majharuli0/smart-speaker-esp32/README.md

# ESP32 Smart Speaker: firmware

Firmware and product docs for an ESP32-S3 smart speaker: alarms with your own tones (they ring even
without internet), a doorbell, hold-to-talk, volume, device health, updates over Wi-Fi, and Wi-Fi setup
over Bluetooth. See [docs/ROADMAP.md](docs/ROADMAP.md) and [docs/APP_PLAN.md](docs/APP_PLAN.md).

The rest of the system lives in its own repos:

| Repo | What |
|---|---|
| **smart-speaker-esp32** (this one) | Firmware, hardware notes, product docs, the device protocol |
| [smart-speaker-backend](https://github.com/majharuli0/smart-speaker-backend) | NestJS API + Postgres, accounts, and the MQTT broker (EMQX) the speakers connect to |
| [smart-speaker-web](https://github.com/majharuli0/smart-speaker-web) | React web app |
| [smart-speaker-app](https://github.com/majharuli0/smart-speaker-app) | Expo (React Native) phone app: adds a speaker by its QR label and Bluetooth |

```
├── firmware/    ESP32 program: firmware.ino (startup + commands), net, audio, alarms, tonecache, ota, health, stats, config.h
├── hardware/    Schematics and enclosure (later)
└── docs/        Roadmap, app plan, protocol; archive/ holds the earlier design doc
```

## 1. Secrets

Copy `firmware/secrets.example.h` to `firmware/secrets.h` (not in git) and set:
- `MQTT_URI`: the broker. At home: `mqtt://speaker-server.local:1883`. The computer running the
  backend's `docker compose` answers to that name (mDNS), so its address can change. In the cloud:
  `mqtts://<domain>:8883`. Each speaker logs in as itself, and the backend checks it.
- `DEVICE_SECRET`: the same value as `DEVICE_SECRET` in the backend's `.env`. It produces each speaker's
  QR label code and its MQTT password.

## 2. Flash the ESP32

All board settings and library versions come from [firmware/sketch.yaml](firmware/sketch.yaml). Needs
[arduino-cli](https://arduino.github.io/arduino-cli/) (`winget install ArduinoSA.CLI`).

```bash
cd firmware
./fw.sh build                 # compile for the ESP32-S3 → build/s3/firmware.ino.bin
./fw.sh upload COM11          # compile + upload (use your port)
./fw.sh monitor COM11         # serial monitor at 115200, Ctrl+C to quit
```

**Over Wi-Fi:** upload `firmware/build/s3/firmware.ino.bin` on the web app's **Firmware** page (admins),
then press **Update** under the speaker's Health. If the new version can't reach the server within
3 minutes, the device goes back to the previous one by itself.

At boot the serial monitor prints the speaker's UID and its label text: `QR label: SS:<UID>:<code>`.

## Making a unit (one command)

With a new ESP32-S3 on USB (Git Bash):

```bash
tools/make-unit.sh COM11          # wipe the chip, flash the firmware, make the label
tools/make-unit.sh COM11 --keep   # same without wiping (keeps Wi-Fi, settings and files)
```

It reads the speaker ID from the chip, builds and flashes the firmware (cloud address and secret from
`firmware/secrets.h`, which must match the backend's `DEVICE_SECRET`), writes the label
(`tools/labels/<UID>.html`: QR + ID, 70 × 40 mm, opened for printing) and adds a line to
`tools/units.csv`. On first start the speaker waits for Bluetooth setup and fetches the built-in tones
from the server.

## 3. Wi-Fi setup (over Bluetooth)

A speaker with no Wi-Fi saved advertises over Bluetooth as **`SS-XXXX`** (last 4 characters of its UID),
with a blue blinking light.

- **Phone app:** *Add a speaker* → scan the label (or type the speaker ID, the last 4 characters are
  enough) → pick your Wi-Fi → password. It's added to your account. A typed ID only works with the phone
  next to the speaker: the speaker itself confirms who set it up.
- **For testing, Espressif's "ESP BLE Provisioning" app:** scan the QR code the serial monitor shows (in
  the app's settings, clear the device name prefix "PROV_").

Bluetooth is switched off once Wi-Fi is set up. **Reset Wi-Fi**, or removing the speaker from your
account, brings it back to Bluetooth setup. Alarms keep working while it waits.

## Hardware

Board: **ESP32-S3-WROOM-1 N16R8** (16 MB flash, 8 MB PSRAM). The firmware only builds for this board.

The full wiring diagram, on the board's real pin order, is [docs/wiring.html](docs/wiring.html) (open it in a browser). The tables below say the same per part. A report-style circuit diagram with photos of each part is [docs/circuit-diagram.png](docs/circuit-diagram.png) (page: [docs/circuit-diagram.html](docs/circuit-diagram.html)).

Amp wiring (MAX98357A; GAIN to GND for 12 dB of gain, SD unconnected):

| Amp pin | ESP32-S3 |
|---|---|
| DIN | GPIO 4 |
| BCLK | GPIO 5 |
| LRC | GPIO 6 |
| VIN | 5V |
| GND | GND |
| GAIN | GND (12 dB) |

Status light (RGB LED, common cathode: the long leg to GND; each color through its own 330 Ω resistor (300 Ω works too)):

| LED leg | ESP32-S3 |
|---|---|
| Red | GPIO 15 |
| Green | GPIO 16 |
| Blue | GPIO 17 |
| Long leg | GND |

| Light | Meaning |
|---|---|
| White, brief | Starting |
| Blue, slow blink | Waiting for Wi-Fi setup over Bluetooth |
| Yellow, blinking | Connecting to Wi-Fi / the server |
| Green, dim (10 s, then off) | Online |
| Red, slow blink | Can't reach the server for 30 s (alarms still ring) |
| Orange, pulsing | Alarm ringing |
| Green, slow pulse | Music playing |
| Purple | Someone is talking through it |
| Cyan, blinking | Doorbell |
| Blue, fast blink | Firmware updating: don't unplug |
| Pink, pulsing | The microphone is on (always shown while it records) |
| White, flashing | "Find my speaker" (Blink button) |

The most important one shows when several apply (top of this order wins: updating, microphone, find, music, ringing, talking, doorbell, setup, offline, connecting, online).

microSD card module (SPI, powered from **3V3** unless the module has its own regulator; card formatted FAT32):

| SD module pin | ESP32-S3 |
|---|---|
| CS | GPIO 10 |
| MOSI | GPIO 11 |
| SCK | GPIO 12 |
| MISO | GPIO 13 |
| VCC | 3V3 |
| GND | GND |

INMP441 microphone (I2S, the second port; **3.3 V only**). Keep its wires short and away from the amp's:

| Mic pin | ESP32-S3 |
|---|---|
| VDD | **3V3** (not 5V) |
| GND | GND |
| SCK | GPIO 7 |
| WS | GPIO 8 |
| SD | GPIO 9 |
| L/R | GND (left channel) |

A second INMP441 can share the same SCK, WS and SD wires with its L/R pin to **3V3** (right
channel): the speaker uses the quieter of the two, and the mic test can record either or both.

Buttons (firmware 0.37.0+): two push buttons, each between its pin and **GND** (no resistor:
the internal pull-up is used).

| Button | ESP32-S3 | What it does |
|---|---|---|
| STOP · SOS (red) | GPIO 1 | Press: stops an alarm, reminder, music, Momo or a call. Hold 3 s: SOS, the family is alerted and their apps ring |
| MOMO | GPIO 2 | Press: Momo listens (like the wake word) |

DS3231 clock module (I2C, optional): keeps the time through power cuts, so alarms ring without
internet. With a plain CR2032 battery on the common ZS-042 board, remove its charging diode or resistor.

| Clock pin | ESP32-S3 |
|---|---|
| VCC | 3V3 |
| GND | GND |
| SDA | GPIO 21 |
| SCL | GPIO 47 |
| SQW, 32K | not connected |

The serial log shows `Clock from DS3231: …` at boot; the first time (new module), it shows
`not set yet` and then `DS3231 set from NTP` once the speaker is online.

Check the mic from the web app: the speaker's page → **Microphone** → **Record a test** (owner only).

Arduino IDE settings, if not using `./fw.sh`: Board **ESP32S3 Dev Module**, Flash Size **16MB**, PSRAM
**OPI PSRAM**, Partition Scheme **16M Flash (3MB APP/9.9MB FATFS)**, library **ArduinoJson** (v7),
upload through the USB-C port labelled **COM**.

## Protocol

The MQTT topics and every device message are in [docs/protocol.md](docs/protocol.md).

The old single-file server (`backend/`) and page (`web/`) were replaced by the repos above; they're in
this repo's git history.
