majharuli0/smart-speaker-esp32/hardware/README.md

# Hardware

Schematics, board layouts and enclosure files go here (roadmap Phase 5).

Current prototype wiring is in the main README.
