majharuli0/smart-speaker-esp32/docs/protocol.md

# Protocol

How the ESP32 and the server talk to each other (over MQTT, through our broker). This is the single reference for the device side: if code and this file disagree, fix one of them.

**Version:** matches firmware `0.13.0` and `smart-speaker-backend`; the audio sections (1b `mic`, 3.5 `turn_again` and `fd`, 3.6 `turn` and `mic_done`, 4, 4b, 6.1 `audio`) are updated to firmware `0.36.0` (2026-10-19). Audio work and its reasons: [AUDIO_PLAN.md](AUDIO_PLAN.md).

> The web page and phone app no longer talk to devices through a WebSocket: they use the backend's REST API and Socket.IO (see the `smart-speaker-backend` README and its Swagger docs at `/api/docs`). The device messages below are unchanged; where a section mentions the browser or `target`, the backend now sends that message on the user's behalf, after checking they own the device.

---

## 1. Connections

| What | Where | Used by |
|---|---|---|
| Web page | `GET http://<server>:3000/` (serves `web/`) | Browser |
| **WebSocket** (all messages below) | `ws://<server>:3000/` | Devices and browsers, one connection each |
| Tone upload | `POST /tones` | Browser |
| Tone download | `GET /tones/<name>.wav` | Device (while ringing), browser (preview) |
| Mic processor | `GET /mic-worklet.js` | Browser (hold to talk) |
| Firmware upload | `POST /firmware` | Browser |
| Firmware download | `GET /firmware/<board>.bin` | Device (while updating) |
| Visitor doorbell page | `GET /bell.html?d=<deviceId>` | Visitor's phone (link or QR code at the door) |
| Ring the doorbell | `POST /bell/<deviceId>` | Visitor page. See section 10. |
| Server discovery | mDNS: `led-server.local` → the server's LAN IP (A record) | Device, at boot |

- The device looks up `led-server.local` once at boot, and keeps retrying every second until it's found. It then keeps a WebSocket open to that IP, reconnecting every 3 s if it drops.
- All HTTP responses allow any origin (CORS `*`, header `X-Filename` allowed), so the page also works when opened as a file.

---

## 1b. Devices over MQTT (firmware 0.11.0+)

Devices connect to the **MQTT broker**, not to the server. Since firmware 0.13.0 that's **our own EMQX** (open source, in `smart-speaker-backend`'s docker-compose), which asks the backend about every login and topic. (0.11–0.12 used EMQX Cloud Serverless with one shared login; Serverless can't ask our backend.) The server connects to the same broker (`MQTT_URL` in `backend/.env`) and bridges devices to the web page, which still uses the WebSocket. **The JSON messages in section 3 are unchanged; only the route is different.**

| Topic | Direction | QoS | Carries |
|---|---|---|---|
| `ss/dev/<id>/cmd` | server → device | 1 | Everything in 3.4 and 3.5 (commands) |
| `ss/dev/<id>/audio` | server → device | 0 | Talk audio (section 4) |
| `ss/dev/<id>/evt` | device → server | 1 | Everything the device sends: `hello`, 3.6, `boot` |
| `ss/dev/<id>/online` | device | 1, retained | `1` on connect; the broker publishes `0` if the device drops (last will) |
| `ss/dev/<id>/mic` | device → server | 0 | Microphone audio (firmware 0.19.0+): 16 kHz 16-bit mono PCM in 120 ms pieces (3,840 bytes; 125 ms before 0.28), only while a `mic_record` runs. The mic is always on from 0.22.0 (for the wake word), but nothing is sent outside a `mic_record`. Since 0.28.0 this topic is only the fallback: mic audio goes over the audio link (section 4b) while it's up |
| `ss/server/online` | server | 1, retained | `1` when up (`0` is its last will). On `1`, a device sends `hello` and its reports again. **Known gap:** the server only counts a device as online after its `hello`. If a device's `hello` arrives while the server's MQTT login is still being refused (a quick restart of the dev server), it is missed, and the device won't say hello again because `ss/server/online` was already `1`. Fix by hand: publish `0`, then `1` (retained) to `ss/server/online`, or restart the backend once more. |
| `ss/server/http` | server | 1, retained | Base URL for downloads (tones, firmware), e.g. `http://192.168.0.102:3000`; `PUBLIC_URL` overrides it |

- **The device ID is taken from the topic**, never from the message, so a device can't pose as another.
- **Login, decided by the backend** (`/api/v1/broker/auth`):
  - each device logs in **as itself**: username = client ID = its device ID, password = HMAC-SHA256(`DEVICE_SECRET`, `"mqtt:" + id`) in hex. It's not the label code, so the printed label doesn't reveal it;
  - the backend logs in with `MQTT_USERNAME` / `MQTT_PASSWORD` (its `.env`) and may use every topic;
  - anything else is refused.
- **Topics, decided by the backend** (`/api/v1/broker/acl`): a device may only publish its own `evt`, `online` and `mic`, and only subscribe to its own `cmd` and `audio` plus `ss/server/online` and `ss/server/http`. So one device can't listen to, command, or pose as another.
- **Address:** `MQTT_URI` in `firmware/secrets.h` (not in git; template `secrets.example.h`). On your own network: `mqtt://speaker-server.local:1883`. The backend answers that name over mDNS with its computer's current address. The device looks it up before connecting, and again if the broker has been unreachable for 30 s (firmware 0.13.1+), so the computer's address may change. On the cloud server it becomes `mqtts://<domain>:8883`, checked against the ESP32's built-in bundle of trusted roots (no certificate file embedded).
- **Old firmware** (before 0.11.0) still connects by WebSocket, and the server accepts both.

---

## 2. Identities

- **Device ID:** `esp32-` + the chip's factory MAC address as 12 lowercase hex characters, e.g. `esp32-2884856409fc`. It never changes for a given chip.
- **UID:** what people see and type: the 12 hex characters in uppercase (`2884856409FC`). The `esp32-` ID is internal (MQTT topics, database, the label code); the API accepts the UID in URLs and when adding a device.
- **QR label:** `SS:<UID>:<code>`, e.g. `SS:2884856409FC:7f3a91c2`, with the UID printed next to it. The code is the first 8 hex characters of HMAC-SHA256(`DEVICE_SECRET`, internal device ID). The secret is in the firmware (`secrets.h`) and the backend (`.env`), so no per-device record is needed. The code is the **proof of ownership** when adding the device from its QR (`POST /api/v1/devices/claim`), which works even while it's online.
- **Adding by typing the ID** (firmware 0.17.0+): the user types the UID, or just its last 4 characters. The app finds `SS-XXXX` over Bluetooth, asks the backend for a **setup token** (`POST /api/v1/devices/claim-token`, valid 15 min, signed with `DEVICE_SECRET`) and writes it to the device's `ss-claim` setup endpoint. Once online, the device sends `{type:"claim", token}` after `hello`, and the backend adds it to that user's account, unless someone else owns it. Knowing a UID isn't enough: a phone has to be next to the speaker while it's in setup.
- **Bluetooth setup session:** Espressif provisioning, security 1 (encrypted). Since 0.17.0 its proof of possession is the Bluetooth name itself (`SS-XXXX`), so a typed ID is enough to connect; before, it was the label code.
- **Wi-Fi setup** (firmware 0.12.0+): with no Wi-Fi saved, the device advertises over Bluetooth as `SS-XXXX` (last 4 of the ID, uppercase) until a phone sends the details; then Bluetooth is switched off.
- **Wi-Fi recovery** (0.14.0+): if the saved network has been unreachable for 5 minutes (new router, changed password), the device also opens Bluetooth setup, while it keeps trying the old network. If the old network comes back first, Bluetooth closes again; if the app sends new details, the device switches to them.
- **Users** log in to the backend (`smart-speaker-backend`); each sees and controls only the devices they've added.

---

## 3. WebSocket messages

All text messages are JSON objects with a `type`. The only binary messages are talk audio (section 4).

### 3.1 Hello (first message on every connection)

| From | Message | Server's response |
|---|---|---|
| Device | `{type:"hello", role:"device", deviceId, fw, board}` | Registers the device, then sends `devices` to all browsers. The device follows up with `volume` and `partitions`. |
| Browser | `{type:"hello", role:"browser"}` | Sends that browser `devices`, `alarms`, `tones`, `firmware`, `events`, `server`, and each online device's latest status reports |

If a device reconnects before its old connection closes, the new connection replaces the old one. The device stays online.

### 3.2 Server → browsers

| Message | When |
|---|---|
| `{type:"devices", devices:[deviceId, ...]}` | On browser hello, and whenever a device comes online or goes offline |
| `{type:"alarms", alarms:[Alarm, ...], versions:{deviceId: version}}` | On browser hello, and after any alarm change. All alarms for all devices, plus the version each device should confirm (see 5). |
| `{type:"tones", tones:["name.wav", ...]}` | On browser hello, and after an upload |
| `{type:"talk_denied", deviceId, reason:"busy"\|"offline"}` | Only to the browser whose `talk_start` was refused |
| `{type:"firmware", firmware:{board: {board, version, size, sha256, uploaded}}}` | On browser hello, and after a firmware upload. The newest file per board. |
| `{type:"events", events:[Event, ...]}` | On browser hello: the newest 50 events (doorbell rings and device restarts) |
| `{type:"event", event:Event}` | A new event: a doorbell ring `{type:"doorbell", deviceId, source:"visitor"\|"page", at, delivered}` or a restart `{type:"boot", deviceId, reason, fw, crash?, at}` |
| `{type:"server", lanUrl}` | On browser hello: this server's network address (`http://192.168.x.x:3000`), for links other devices open. `null` if it has no network. |
| `{type:"doorbell_result", deviceId, ok:false, reason:"offline"}` | Only to a page whose `doorbell_ring` couldn't reach the device |

### 3.3 Browser → server (handled by the server, not relayed)

| Message | Effect |
|---|---|
| `{type:"alarm_save", alarm:Alarm}` | Create (no `id`) or replace (same `id`). Invalid alarms are ignored silently. See section 5. |
| `{type:"alarm_delete", id}` | Delete the alarm |
| `{type:"talk_start", target}` | Starts a talk session if nobody else is talking to `target` and it's online. Otherwise replies with `talk_denied`. On success it's also relayed to the device. |
| `{type:"talk_stop", target}` | Ends the session; also relayed to the device |
| `{type:"ota", target}` | Update `target` to the newest firmware for its board: sends it `ota_start`. If there's no file for its board, or it's offline, replies `{type:"ota", deviceId, state:"failed", error}`. |
| `{type:"doorbell_ring", target}` | Ring that device's doorbell (the page's 🔔 button). See section 10. |
| `{type:"set_timezone", target, tz}` | Saves an IANA zone name (e.g. `Asia/Dhaka`) for that device and sends it a `timezone`. Unknown names are ignored. |

### 3.4 Browser → device (relayed as-is to `target`)

The server forwards any other browser message to the device named in `target`. If the device is offline, the message is dropped.

| Message | Device does |
|---|---|
| `{type:"blink", target}` | "Find my speaker": the status light flashes white for 4 s |
| `{type:"ring", target, tone}` | Plays `tone` now (the **Test tone** button). Same behaviour as an alarm. |
| `{type:"stop", target}` | Stops ringing and talk |
| `{type:"snooze", target}` | If ringing: stop now and ring the same tone again in **9 minutes** (fading in). Timed by the device, so it works offline. Replies `snoozed`. |
| `{type:"talk_start", target}` / `{type:"talk_stop", target}` | See 3.3 and section 4 |
| `{type:"volume", target, value}` | Sets volume 0–100 and saves it on the device, then replies with `volume` |
| `{type:"volume", target}` | Only asks; the device replies with `volume` |
| `{type:"repeat", on}` | Music played from the file manager starts again at the end (`true`, the default) or plays once; saved on the device, which replies with `repeat`. Without `on`, it only asks. |
| `{type:"partitions", target}` | Asks for the flash layout; the device replies with `partitions` |
| `{type:"reset_wifi"}` | Forgets Wi-Fi and restarts into Bluetooth setup (`SS-XXXX`, firmware 0.12.0+) |

### 3.5 Server → device (from the server itself)

| Message | When |
|---|---|
| `{type:"timezone", tz, name}` | On connect, then every hour. `tz` is the POSIX rule the ESP32 uses, `name` the IANA zone. See section 8. |
| `{type:"alarms_sync", version, alarms:[{id, time, days, date?, tone, fade?, enabled}], tones:[{name, size, sha256}]}` | On connect, after any change to this device's alarms, and when a tone they use is re-uploaded. Only its own alarms, plus the tones they use (section 5). |
| `{type:"talk_stop"}` | The browser that was talking closed its tab or lost its connection |
| `{type:"watch", on}` | On hello, and whenever the first page opens (`true`) or the last one closes (`false`). Sets the stats rate. |
| `{type:"ota_start", path, version, size, sha256}` | After a browser's `ota`. See section 9. |
| `{type:"doorbell"}` | Someone rang: play the ding-dong |
| `{type:"sos_sent", people}` | The answer to the speaker's `sos` (0.37.0+): how many family members got the alert (a phone or an open app). The speaker stops resending it; 0: it plays its falling "no" notes (the server also says so in Bangla) |
| `{type:"momo_failed"}` | The MOMO button was pressed, but Momo can't start now (already listening, voice off, the day's limit): the speaker plays its falling notes |
| `{type:"mic_record", seconds, endSilence?, live?, wakeTake?, wakeTest?}` | Record (1–20 s): the device stops any sound, records, and streams it on `ss/dev/<id>/mic`; the light pulses pink meanwhile. With `endSilence` (ms) it plays its cue, starts 100 ms after it, and stops by itself once someone has spoken and then been quiet that long (a voice request): speech is 12 dB above the room's background, measured in 50 ms steps. The microphone test and voice requests both use it. Firmware 0.20.0+ (0.19.0 called it `mic_test`, without `endSilence`). From 0.22.0: **`live: true`** is a call (up to 600 s): the cue plays, talk keeps playing, and nothing is sent while the speaker plays sound or for 200 ms after (no echo of the caller); **`wakeTake: 1-3`** keeps the longest word said as that take of the wake word; **`wakeTest: true`** scores the word said against the takes (results in `mic_done`) |
| `{type:"mic_stop", quiet?}` | End a recording, call or conversation early (`stop` does too); `mic_done` still follows. A conversation ends with its falling tone unless `quiet` (0.26.0+) |
| `mic_record` with **`conversation: true, endSilence, idle`** | A conversation (0.26.0+): streams like a call (nothing sent while the speaker plays), and keeps the turns: `turn` events when the person starts and stops speaking (a turn ends after `endSilence` ms of quiet), a rising beep and pink light when it's their turn again after the AI's voice has played, blue while the AI thinks, purple while it speaks. Ends by itself (falling tone, `endedBy: "idle"`) when they say nothing for `idle` ms on their turn. With `afterWake: true` it starts from the start of the wake word, without a beep |
| `mic_record` with **`live: true, fd: true`** | A call in full duplex (0.35.0+): the speaker runs its echo canceller (ESP-SR) on the room audio, so it keeps sending the room while it plays the caller's voice, with that voice taken out. If the canceller isn't ready the call is half duplex as before; `mic_done` says which (`fd`). The server sends `fd` unless `CALL_DUPLEX=0`; older firmware ignores it. The wake word still doesn't listen while the speaker plays, and conversations stay half duplex. From 0.35.1 a call (`live`, with or without `fd`) chimes softly when it starts (2.6 s; the caller's talk waits for it), plays three falling notes when it ends, and keeps the light pink throughout |
| `mic_record` with **`ns: 1-3`** | Noise filter on the sent audio (0.36.0+): a 180 Hz high-pass, then noise suppression (1 mild, 2 medium, 3 aggressive) on core 0; the speech and turn detection keep the raw sound. Ignored for wake word takes and tests. The server sends it for calls (the speaker's `noiseFilter` setting: off, light, medium, strong = no `ns`, 1, 2, 3) and microphone tests that ask for it; not for conversations (Momo hears the raw sound) |
| `mic_record` with **`mic: 1-3`** | Which mic (0.36.1+), when two share the port (one's L/R pin to GND = left, the other's to 3V3 = right): 1 left, 2 right, 3 both averaged. Without it (0): the one the speaker picked at power-on, from each slot's quietest 50 ms over 2 s: no mic (almost nothing) and a floating line (near full scale) are skipped, and of the mics the quieter is used. Only microphone tests send it; calls and conversations use the picked mic |
| `{type:"wake_config", enabled, sensitivity}` | Wake word on/off and sensitivity 1–10 (higher wakes more easily). Sent by the server after `hello` and on change; the device keeps it. Firmware 0.22.0+ |
| `{type:"wake_clear"}` | Forget the wake word takes (0.22.0+) |
| `{type:"turn_again"}` | In a conversation (0.34.0+): the server set the person's last turn aside (too little sound in it, or Momo called it noise), so it's their turn again: the light goes back from blue to listening, with no beep. Older firmware ignores it and stays "thinking" until its 12 s limit |

### 3.6 Device → browsers (relayed to all browsers, with `deviceId` added)

| Message | When |
|---|---|
| `{type:"ringing"}` / `{type:"stopped"}` | A tone (or the built-in beep) starts / stops: Stop pressed, or the 60 s limit reached |
| `{type:"alarms_ack", version, count}` | After every `alarms_sync`: the list is saved on the device |
| `{type:"alarm_fired", alarmId, time}` | The device rang an alarm from its own clock |
| `{type:"snoozed", until}` | After `snooze`: local time it will ring again (`"07:09"`), or `""` if the clock isn't set |
| `{type:"boot", reason, fw, crash?}` | Once per boot, on first connect: why it restarted. Not relayed as-is: the server logs it as an `event` (section 11). |
| `{type:"ota", state, progress?, error?, version}` | Update progress: `downloading` (0–100, every 10%), `restarting`, then from the new version `done`, or `failed`. `rolled_back` means the new version failed to start and the device went back to `version`. |
| `{type:"cache", stored, wanted, card}` | How many of its alarms' tones are stored on the device (on the card, built-in, or both), and whether a microSD card is in. After each sync, each finished download, and when a card is inserted or removed. |
| `{type:"talking"}` / `{type:"talk_stopped"}` | Talk playback starts / ends |
| `{type:"volume", value}` | On connect, and after any `volume` request |
| `{type:"repeat", on}` | On connect, and after any `repeat` request |
| `{type:"stats", ...}` | Every **2 s while a page is open**, otherwise every **5 min** (keeps MQTT traffic low). See 6.1. |
| `{type:"partitions", ...}` | On connect, and when asked. Measured once at boot. See 6.2. |
| `{type:"mic_level", rms, peak}` | Every 250 ms during a microphone test: levels in dB of full scale (0 = as loud as it goes), for a live meter. Sent at once (QoS 0), like the audio: the queue for other reports goes out about one message per pass of the MQTT task, far too slow for live data |
| `{type:"wake_status", enabled, sensitivity, takes:[s,s,s], threshold, spread, listening}` | The wake word (0.22.0+): each take's length in seconds (0 = none), the match threshold and the takes' average distance from each other, and whether it's listening (on, with all 3 takes). On connect and on every change |
| `{type:"button", button:"stop"\|"momo"}` | A button (0.37.0+, GPIO 1 and 2). `stop`: the speaker has already stopped everything itself (alarm, music, talk, the mic session: a call or conversation ends with its `mic_done`); the server logs a `button` event. `momo`: a short press; the server starts a conversation as the owner, like `wake` (or answers `momo_failed`) |
| `{type:"sos"}` | STOP held 3 s (0.37.0+): the server alerts every family member (an urgent push, and their open apps ring like a call, marked `sos`), answers `sos_sent`, logs an `sos` event and says in Bangla that the family was told. Sent again every 5 s until answered (up to 10 minutes, so it goes once the speaker is back online); the speaker blinks red meanwhile and for 30 s after |
| `{type:"wake", score, threshold}` | The wake word was heard (score ≤ threshold; lower is closer). Not again for 3 s. The server starts a conversation as the owner (0.25.0+: the match is loose on purpose, and the AI checks the recording really starts with the wake phrase; if not, the speaker stays silent) |
| `{type:"turn", state:"speaking"\|"done", pieces, speech?}` | In a conversation (0.26.0+), sent at once: the person started / stopped speaking. `pieces`: how many `mic` pieces were sent before it, so the server can include the start (and wait for the end) of the turn. `speech` (0.34.0+, on `done` only): how long they spoke in ms, the turn less the quiet that ended it. The server holds a turn until `done` and sets aside one with under 200 ms of sound (it answers `turn_again`) |
| `{type:"mic_done", samples, pieces, dropped, clipped, slot, gainShift, speech, endedBy, floorDb, wake?}` | The recording ended (`endedBy`: `silence`, `time` or `stop`; `speech`: someone spoke): samples recorded, pieces sent, pieces that couldn't be sent (not connected), samples clipped, which I2S slot was used (`left`/`right`, the mic's L/R pin; `both` when averaged), `slots: {left, right}` (0.36.1+: each slot's quietest 50 ms in the session, dB of the mic's full scale; about -120 with no mic there), and the gain (`MIC_GAIN_SHIFT`: 8 = x1). `{type:"mic_done", error}` if the mic's I2S port didn't start. `wake` (0.22.0+): for a take `{take, ok, seconds?}`; for a test `{test, heard, seconds?, score (null: too long or short to compare), threshold, match}`. With a noise filter (0.36.0+): `ns` (its level) and `nsDrops` (10 ms frames lost on the way). A call (0.35.0+): `fd` (true: it ran in full duplex) and, if so, `aec: {echoDb, echoMs, usPerChunk}`: how far the speaker's own sound was taken down in the room audio (speech band, over all of it), for how long it played, and the canceller's time per 32 ms chunk |

---

## 4. Talk audio (binary)

```
browser: talk_start → binary chunk, chunk, ... → talk_stop
```
- **Format:** raw PCM, 16 kHz, 16-bit signed little-endian, mono. The browser sends **640-byte chunks** (320 samples = 20 ms) over its live connection.
- **Routing:** the server forwards a browser's audio only to its current talk target, and only between `talk_start` and `talk_stop`. Everything else is dropped.
- **Over the audio link (section 4b), as it comes:** each chunk goes on at once (Opus, in 20 ms frames). The AI's voice goes in 40 ms pieces, paced to play time, 240 ms ahead.
- **Over MQTT (the fallback), in pieces of 125 ms:** the server joins the chunks and publishes one message every 125 ms (4,000 bytes, 8 messages a second). EMQX Serverless allowed a client only **10 published messages a second**: one message per 20 ms chunk (50 a second) was queued by the broker and fell seconds behind. The AI's voice goes 375 ms ahead. Any command for the device first sends the audio still waiting, so `talk_stop` always comes after the last words.
- **No late audio:** the browser sends chunks as "volatile" (dropped if the connection is busy), and audio is QoS 0 (never resent).
- **Device** (firmware 0.11.2+; numbers from 0.33.0):
  - Holds a 16,000-sample buffer (1 s). It starts playing once 2,000 samples (125 ms) are buffered (3,000 before 0.33), and drops the oldest audio when the buffer is full.
  - If more than 500 ms is waiting while it plays (a burst after a stall), it skips back to 250 ms, so the delay doesn't stay raised (counted as `talkSkips`).
  - If no audio arrives for 150 ms, it waits for the buffer to build up again before resuming.
  - Played audio then waits in a 64 ms ring (128 ms before 0.33) and the amp's 64 ms queue.
  - On `talk_stop` it plays what's left in the buffer, then stops.
- **Priority:** an alarm, or a `ring` from the **Test tone** button, stops talk.
- The mic only works on `https://` or `http://localhost`, a browser rule.
- **A call, the other way** (0.22.0+): the page sends `listen_start {deviceId}` over its live connection (any family member; answers `{ok, reason}`), the server sends the device `mic_record {seconds: 600, live: true, fd: true}`, and passes each 125 ms piece on as binary `listen_audio`. `listen_stop`, closing the page, or the device stopping (`listen_end {deviceId}`) end it. Talk works at the same time: in full duplex (0.35.0+, `fd`) the device takes the caller's voice out of the room audio and keeps sending; otherwise it sends nothing while it plays the caller's voice.

---

## 4b. Audio link (firmware 0.28.0+)

Live audio both ways goes over its own WebSocket, not through the broker: talk and the AI's voice down, the mic up. Commands and reports stay on MQTT.

- **Where:** the server announces the URL in the retained topic `ss/server/audio`: `AUDIO_LINK_URL` in the backend's `.env` (cloud: `wss://smart-speaker.duckdns.org/api/audio-link`, through Caddy), else `ws://<its LAN address>:4000/api/audio-link`.
- **Login:** the first text frame is `{"type":"hello","id":"esp32-…","password":"<its MQTT password>","codec":"opus"}`; the server answers `{"type":"ok"}` within 5 s, or closes. Without `"codec":"opus"` the link carries raw PCM.
- **Binary frames:** `[type: 1 byte][seq: 2 bytes, big-endian][payload]`. Types: `0x01` mic Opus, `0x02` talk Opus, `0x03` mic PCM, `0x04` talk PCM. An Opus payload is a run of 20 ms frames, each `[length: 2 bytes, big-endian][frame]` (16 kHz mono, VOIP, 24 kb/s; the speaker encodes at complexity 2). A mic message is one 120 ms piece (6 frames). The speaker decodes at most 16 frames (320 ms) of one talk message. Each side numbers its frames: the other counts gaps (`micGaps` on the server, `rxGaps` on the speaker).
- **Text frames:** `talk_start` and `talk_stop` go on the link (in order with the audio); the speaker sends `{"type":"ping"}` after 15 s of sending nothing; the server sends `{"type":"ka"}` every 5 s (backend from 2026-10-18).
- **Staying alive:** the server pings every 5 s and closes a link that misses 2 (10-15 s). If more than about 1 s of talk audio is waiting to go, new audio is dropped; stuck like that for 3 s, the server closes the link. The speaker's WebSocket library answers pings itself and never shows them, so from 0.33.0 it watches `ka` instead: once one has come, 30 s with nothing from the server makes it reconnect. It retries every 2 s.
- **Fallback:** while the link is down, mic audio goes to `ss/dev/<id>/mic` and talk to `ss/dev/<id>/audio` (raw PCM, section 1b and 4).

## 5. Alarms

Alarms **ring on the device**, from its own clock and time zone, so they work with the network or server down. The server only keeps the list and delivers it.

```json
{ "id": "uuid", "deviceId": "esp32-…", "time": "07:00", "days": [1,2,3,4,5],
  "tone": "wake.wav", "enabled": true }
// one-time: { …, "days": [], "date": "2026-10-12", … }
```

| Field | Rule |
|---|---|
| `id` | Created by the server when missing |
| `time` | `HH:MM`, 24-hour, in the **device's** time zone (section 8); must match `^dd:dd$` |
| `days` | Weekdays, `0` = Sunday … `6` = Saturday; other numbers are dropped. Empty for a one-time alarm. |
| `date` | Optional `YYYY-MM-DD`: a **one-time** alarm that rings on that date only (`days` is then ignored). When the device reports `alarm_fired` for it, the server sets `enabled:false`. An alarm needs a valid `date` or at least one weekday. |
| `tone` | A file in the tone library. Only the file name is kept (paths are stripped). |
| `fade` | Only sent as `false` (firmware 0.18.0+): a spoken message, such as a reminder recorded in the app. It plays at full volume from the first word, with no fade-in. Missing means `true`. |
| `enabled` | Defaults to `true` |

**Delivery:**
```
page: alarm_save / alarm_delete → server saves alarms.json
server → device: alarms_sync {version, alarms}      (on connect + after each change)
device: saves the list in flash → alarms_ack {version, count}
```
- **`version`** is a hash of the device's list. An unchanged list keeps its version, so the device doesn't re-save it on every reconnect. The page compares `alarms_ack.version` with `alarms.versions[deviceId]` to show "saved on the device".
- **Storage:** server in `backend/alarms.json` (or `DATA_DIR`); device in its settings storage, up to 20 alarms. Both survive restarts.

**Ringing (on the device):**
- It checks the list once per minute, right as the minute starts, **only after its clock is set** (`timeValid`). So an alarm never rings at a wrong time, and never twice in the same minute.
- If several alarms are due in the same minute, the first one wins.
- **Fade-in:** alarms (and snooze re-rings) start at 10% of the set volume and rise to full over **30 s**. **Test tone**, and alarms with `fade:false` (and their snooze re-rings), play at full volume straight away.
- It plays the tone **from its own storage** if stored, looping with no gap. Otherwise it streams it over HTTP, downloading it again on each loop. Either way it rings until `stop`, or for **60 s** at most.
- If the tone **can't be downloaded** (no network, server down, file missing, or 3 s timeout), it plays a **built-in beep** (880 Hz, 0.25 s on / off) instead of staying silent.
- **Stored tones:** `tones` in `alarms_sync` lists every tone the device's alarms use. The device:
  - downloads missing ones in the background, one small piece per loop, so audio and commands keep working;
  - writes each to a temporary file, checks size and **SHA-256**, then renames it to `/<first 8 hex of sha256>.wav`;
  - deletes stored tones no alarm uses any more;
  - retries a failed download 30 s later.

  Because files are named by their hash, a re-uploaded tone (new content) is a new file.
- **Where tones are kept:** the **microSD card** (if inserted, FAT32) and the built-in 9.9 MB `ffat` partition, formatted on first boot. Each tone is kept in **both** when it fits, so an alarm still has its tone if the card is pulled. Playing tries the card first, then built-in storage. Clean-up only touches the device's own files (`<8 hex>.wav` / `.tmp` in the card's root); anything else on the card is left alone.
- **Card in / out:** a missing card is looked for every 5 s, but not while sound is playing, since starting a card can take a moment. A card that's in is checked every 5 s by reading block 0. A failed read while playing triggers that check at once, and playback carries on from built-in storage.
- **After a restart with no internet,** the clock can't be set (no battery-backed clock yet), so alarms wait until the internet is back.

---

## 6. Device reports

### 6.1 `stats` (every 2 s while a page is open, else every 5 min)

| Field | Meaning |
|---|---|
| `heapFree`, `heapTotal` | Internal RAM free / total (bytes) |
| `heapMin` | Lowest free RAM since boot. If this keeps falling, memory is leaking. |
| `heapMaxBlock` | Largest single free block |
| `psramTotal`, `psramFree` | PSRAM, `0` on boards without it |
| `appUsed`, `appTotal` | Program size / program space, measured once at boot |
| `nvsUsed`, `nvsTotal` | Settings storage, in entries |
| `flashSize` | Flash chip size in bytes |
| `cpuMhz` | Clock speed |
| `cpu` | `[core0 %, core1 %]`. Core 0 runs Wi-Fi; core 1 runs the sketch. |
| `uptime` | Seconds since boot |
| `rssi` | Wi-Fi signal in dBm |
| `fw` | Firmware version |
| `board` | Chip type (`esp32s3`, `esp32`): which firmware file fits |
| `time` | Device's local time `YYYY-MM-DD HH:MM:SS`, or `""` until the first internet time sync |
| `tz` | Device's time zone name |
| `audio` | (0.32.0+) Counters for the audio path, totals since boot: `talkDrops` (talk buffer full), `talkStarves` (talk ran dry), `talkPeak` (most samples ever waiting), `talkSkips` (0.33.0+, skipped ahead after a burst), `underruns` (output blocks short of audio while talk played; only right from 0.33.0), `inboxDrops`, `outboxDrops` (mic pieces the link couldn't take), `linkDowns`, `sendMaxMs` (slowest link send), `rxGaps` (talk frames missing). The server's side of the link: `GET /api/v1/devices/:id/audio-stats`; round trip through the speaker: `POST /api/v1/devices/:id/latency-probe` (owner) |

### 6.2 `partitions`

```json
{ "type": "partitions", "flashSize": 16777216,
  "list": [ { "name": "app0", "kind": "app", "offset": 65536, "size": 3145728,
              "used": 1334751, "note": "running program" }, … ] }
```
- `kind`: `app` | `nvs` | `files` | `system` | `other`.
- `sd`: `{present}`, plus `{type, size, total, used}` (bytes) when a microSD card is in, or `problem` (why it didn't mount) when it isn't. Sent again when a card is inserted or removed. To find the problem, the device sends the card the SD reset command (CMD0) directly: no reply means power or contact (it also tries every order of the four signal wires to rule out swapped wires); a reply means the card is fine but won't mount (format).
- `used` is only present when measured: the running app, NVS, and a formatted file storage (which also has `fsTotal`).
- The page adds a `bootloader` row for the space before the first partition.

---

## 7. HTTP: tones

- **Upload:** `POST /tones`
  - The file name goes in the `X-Filename` header, and the body is the file itself. It works with or without a `Content-Type` header.
  - The name is reduced to a file name, and characters outside `[A-Za-z0-9_.-]` become `_`. It must end in `.wav`.
  - Limit is 20 MB. The response is `200`, or `400` for a bad name or an empty body.
  - On success, all browsers get a `tones` message.
- **Format:** the page converts every upload to **16 kHz, 16-bit, mono WAV with a 44-byte header**, first 30 s only. The device skips exactly 44 bytes, so other WAV layouts will play as noise.
- **Download:** `GET /tones/<name>.wav` includes `Content-Length`. The device uses it to know where the file ends.

---

## 8. Time

- **Clock:** the device gets the time from NTP (`pool.ntp.org`, `time.google.com`) after Wi-Fi connects, and ESP-IDF resyncs it every hour. Until the first sync, `time` in `stats` is empty and the clock must not be trusted.
- **Time zone:** the server keeps one IANA zone per device in `devices.json` (in `DATA_DIR`). If none is set, it uses `TZ_DEFAULT`, or the server machine's own zone.
- **POSIX rule:** the ESP32 needs the zone as a POSIX rule, built from the zone's current UTC offset. POSIX counts hours *west* of UTC, so the sign flips: `Asia/Dhaka` → `<+06>-6`, `Asia/Kolkata` → `<+0530>-5:30`, `America/Argentina/Buenos_Aires` → `<-03>3`, UTC → `UTC0`.
- **Daylight saving:** the rule has no DST dates in it. The server re-sends every hour, so a device is at most an hour late switching, and only if it's online.
- The device saves the last zone it received, so it keeps the right local time after a restart even before the server connects.

---

## 9. Firmware updates over Wi-Fi

- **Upload:** `POST /firmware` with `firmware/build/<profile>/firmware.ino.bin` as the body (made by `./fw.sh build`). The server checks:
  - the first byte is `0xE9`, the ESP32 program-image byte;
  - the marker `SSFW:<board>:<version>:END` is in the file. The firmware carries it (`ota.cpp`), so the board and version come from the file itself;
  - the file is at most 3 MB, the program slot (the 16 MB `merged.bin` is refused).

  It keeps only the newest file per board, in `firmware/<board>.bin` + `.json` under `DATA_DIR`.
- **Update:**
  ```
  page: ota {target} → server: ota_start {path, version, size, sha256} → device
  device: downloads into the spare program slot, checks SHA-256, the update library checks the image,
          marks it to boot, restarts → reports ota progress throughout
  ```
  Audio stops during the update. The device does nothing else for the few seconds it takes.
- **Rollback:** the new version starts **on probation**. It becomes permanent once it connects to the server (`ota` `done`). If it doesn't within **3 minutes**, or it crashes and restarts, the bootloader starts the previous version, which reports `rolled_back` once on its next connect.
- **Not yet:** signed firmware. It needs secure boot, which comes with the factory setup (roadmap 5.4).

---

## 10. Doorbell

- **Ringing:** from the owner's page (`doorbell_ring`) or the visitor page (`POST /bell/<deviceId>`, opened from a link or QR code at the door). Only real device IDs (`esp32-` + 12 hex) are accepted.
- **No cooldown:** every press rings. A press during the ding-dong starts it again.
- **Device:** `doorbell` plays a built-in **ding-dong**: two bell strikes, E5 then C5, about 2 s, at the device's volume. It's generated in code, so it needs no file or network. It's skipped if an alarm or talk is already playing.
- **Log:** every ring, delivered or not, is saved newest-first in `events.json` (`DATA_DIR`, last 100) and announced to all pages as `event`. Pages show the last 3 per device. A visitor's ring shows a banner and changes the tab title, plus a system notification if the page was allowed to send them (asked on the first 🔔 button press).
- **Not yet:** a physical button and ringing over Bluetooth (roadmap 1.6 / 1.12).

---

## 11. Reliability

- **Watchdog:** at the end of `setup()` the device turns on the loop watchdog. If `loop()` doesn't come round for **5 s**, the chip restarts and reports `froze`. Long jobs (firmware download, opening a tone stream) feed it as they go.
- **Restart reason** (`boot.reason`): `power_on`, `restart` (update, Wi-Fi reset…), `crash`, `froze` (a watchdog), `brownout` (the supply voltage dipped: weak USB cable or port, or loud audio on a weak supply), `reset_pin`, `usb_reset`, `deep_sleep`, `unknown`.
- **Crash report:** after a crash, the ESP32 saves a report in the 64 KB `coredump` partition. On the next boot the device reads a summary, sends it as `boot.crash = {task, pc, backtrace:[…]}`, then erases it. The addresses can be turned into source lines with the build's `.elf` file.
- **Page:** each device shows its last restart, in red with ⚠ for `crash`, `froze` and `brownout`, plus a banner. The RAM row shows ⚠ low memory when the lowest free RAM since boot drops under 32 KB.
