majharuli0/smart-speaker-esp32/docs/circuit-diagram.png

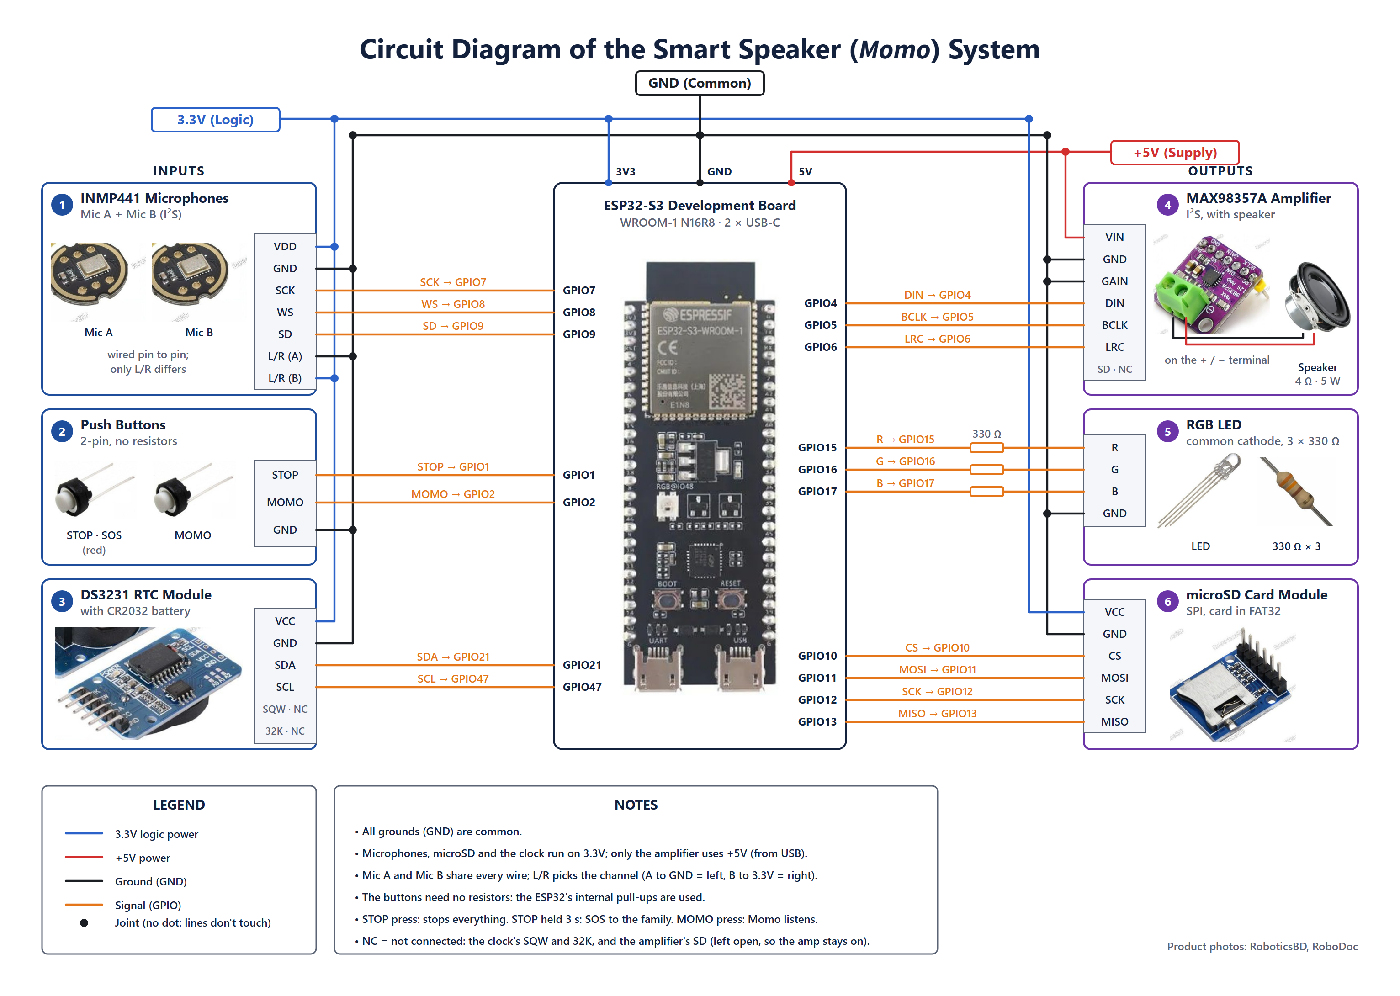
docs/circuit-diagram.png
