majharuli0/smart-speaker-esp32/docs/wiring.html

ESP32-S3-WROOM-1 N16R8 DevKit · firmware 0.37.0

# Smart Speaker Wiring

Every part on its real pin, laid out on the board's header order as printed. Signal wires are drawn; power and ground are shown as labelled tags at each part, so every tag with the same name is one connection.

Amp (I²S out) Mics (I²S in) microSD (SPI) Buttons Clock (I²C) 3V35VGND connect to the board pin of the same name pin to leave free

The two mics share three wires: a dot is a joint, and wires that cross without a dot don't touch. Mic A's L/R goes to GND and Mic B's to 3V3; that is the only difference between them.

## Pin map

Board pin | Goes to
1 | STOP · SOS button (other leg to GND)
2 | MOMO button (other leg to GND)
4 | Amp DIN
5 | Amp BCLK
6 | Amp LRC
7 | Both mics SCK
8 | Both mics WS
9 | Both mics SD
10 | microSD CS
11 | microSD MOSI
12 | microSD SCK
13 | microSD MISO
15 | 330 Ω → LED red leg
16 | 330 Ω → LED green leg
17 | 330 Ω → LED blue leg
21 | Clock SDA
47 | Clock SCL
3V3 | Both mics VDD, Mic B L/R, microSD VCC, clock VCC
5V | Amp VIN
GND | Every part's GND, amp GAIN, Mic A L/R, LED long leg, both buttons

## Parts

Qty | Part (where we bought it)
1 | ESP32-S3-WROOM-1 N16R8 DevKit (https://store.roboticsbd.com/development-boards/2367-esp32-s3-wroom-1-dual-type-c-usb-n16r8-micropython-board-robotics-bangladesh.html) (16 MB flash, 8 MB PSRAM, 2 × USB-C)
1 | MAX98357A I²S amp (https://store.roboticsbd.com/electronics-module/2919-max98357a-i2s-dac-class-d-mono-amplifier-module-robotics-bangladesh.html) + speaker, 4 Ω, 5 W
2 | INMP441 I²S microphone (https://store.roboticsbd.com/sensors/1753-inmp441-compatible-omnidirectional-microphone-module-robotics-bangladesh.html)
1 | microSD card module (SPI) (https://store.roboticsbd.com/electronics-module/2759-microsd-card-module-robotics-bangladesh.html), card in FAT32
1 | DS3231 clock module (ZS-042) (https://store.roboticsbd.com/date-time-rtc-module/386-precision-real-time-clock-module-ds3231-at24c32-i2c-robotics-bangladesh.html) + CR2032 battery
1 | RGB LED, 5 mm, common cathode (https://robodocbd.com/product/rgb-led-5mm)
3 | 330 Ω resistor, ¼ W (https://robodocbd.com/product/330-ohm-1-4w-resistor) (300 Ω works too)
2 | Push button, 2-pin (https://robodocbd.com/product/push-switch-2-pin) (STOP · SOS in red, MOMO)
