majharuli0/smart-speaker-esp32/docs/NEXT_STEPS.md

# Next steps: handoff and plan (written 2026-10-16, updated 2026-10-17 after steps 0, 1, blocks B1, B3, B2, B5, B4 and step 3)

Read this file first in a new chat. It covers what is live, how we work, what we measured, and what to do next, in order.

**To start a new chat, say:** *"Read `led-demo/docs/NEXT_STEPS.md` and start with step 2, block B4. Check with me on scope first."* (B4 = Momo remembers: notes and preferences per speaker. Then step 3. B5, the context Momo and routines know, is built: see "B5 progress".)

**2026-10-18: the audio plan (current work).** Two-way voice was reworked in phases: see [AUDIO_PLAN.md](AUDIO_PLAN.md), which has the status, the measurements and what's next. Done, tested and deployed (backend `8101c34`, web `5856910`, firmware 0.34.0, app `5b95393`; backup `~/backups/speaker-20261018-161749.*`): audio counters and a latency probe (phase 0); lower delay, faster dead-link detection and a link watchdog (phase 1, which also settles step 1's items 2 "a bit of delay" and the audio link that didn't come back); and Momo fixes (no repeated answers, no answers cut by noise, bulk alarm actions, the speaker's confirmation of alarm changes, the 20-alarm limit). Phase 2 (full-duplex calls, one Call button in web and app, the speaker's call chime) and a Momo prompt fix (only Bangla or English is for it) followed on 2026-10-18/19: see AUDIO_PLAN.md. Phase 3 so far (2026-10-19): a noise filter for calls (off, light, medium, strong, a setting per speaker; Momo hears the raw sound). Next: gain control with the clients' +16 dB removed. All four repos work on branch `feat/audio-duplex`, fast-forwarded into `main` after each tested step.

**Deployed 2026-10-17 14:15-14:18 UTC: Momo memory fix** (backend `42981af`, `f6dd497`; backup `~/backups/speaker-20261017-141514.*`). Found by the owner: item places were saved without the thing ("ড্রয়ারের ভিতর"), so "চশমা কোথায়?" offered every place. Now the note always names the thing ("চশমা: ড্রয়ারের ভিতর"), a place without a thing is refused, and words match in either encoding of য়. The two cloud notes were renamed by hand (চশমা, মানিব্যাগ, from the voice log).

**Deployed to the cloud 2026-10-17 (12:35-12:40 UTC):** backend `9cc1be6` (includes `98bdb35`, wake check), web `501f085`, firmware 0.31.1 (`led-demo` `691a013`, flashed over USB). Backups: `~/backups/speaker-20261017-123558.*`. New: **DS3231 battery clock** (GPIO 21/47; boot events carry `clock: "rtc"`, verified in the cloud database; Health shows "Battery clock working") and **12-hour times on the web** (AM/PM picker for alarms, routines and care routines). Still to test by the owner: an alarm with the router off after a power cut. The phone app already shows 12-hour times; only its care-routine time box asks for 24-hour input ("08:30", `app/care.tsx`).

**Deployed to the cloud 2026-10-17 (08:14-08:30 UTC):** everything up to backend `a10eb71`, web `4bf42e4`, app `248b621`, firmware 0.30.2 (`led-demo` `1050625`) is pushed to GitHub and live on smart-speaker.duckdns.org.
- Backups first: `~/backups/speaker-20261017-081434.sql.gz` (11 tables, complete) and `speaker-files-20261017-081434.tgz`.
- Backend rebuilt; 8 migrations applied on start (`notify_settings` … `call_seen`); log: "Voice on (Gemini)", "Push notifications on (Firebase)", "MQTT connected". Web `dist` replaced; site 200, API up, audio-link route 101.
- Speaker reflashed with `secrets.h` → `mqtts://smart-speaker.duckdns.org:8883`: boot log "Server online"; server log "Device online", "audio link up (Opus)". **The speaker is on the cloud now:** to work locally again, switch `MQTT_URI` back to the local line and reflash.
- **Settled:** the cloud dropout at 22:12 UTC on 2026-10-15 was a `froze` restart on 0.30.1 (the freeze fixed in 0.30.2), not the network.
- **Still to check by the owner:** the RAM line on the speaker page (Device tab → Health) with TLS, a 2-minute 📞 Call, and a new phone app build (it has all the new screens).
- Everything below in this file about "not pushed, not deployed" is history from before this deploy.

---

## 1. Where things stand

Everything in the table is **pushed to git and deployed on the cloud** (smart-speaker.duckdns.org, Oracle VM in Singapore), except where the next block says otherwise.

| Part | Version / commit | What it has |
|---|---|---|
| Firmware | **0.30.1** (`led-demo` `5780c04`) | Opus audio over its own WebSocket (`wss://…/api/audio-link`). Steady audio output (the amp is always fed). ESP-SR echo canceller, used only by the echo test. TLS buffers in PSRAM, so both secure connections fit. |
| Backend | `smart-speaker-backend` `19feebf` | Audio link service (Opus, falls back to MQTT). Echo test options on the mic test. Old-answer audio dropped after the person speaks again. **66 e2e tests pass.** |
| Web | `smart-speaker-web` `69c5987` | Mic page with **🔊 Echo test** and **🔊 Echo test (AEC)** buttons |
| Cloud server | `.env` has `AUDIO_LINK_URL=wss://smart-speaker.duckdns.org/api/audio-link` | Backup taken before deploy: `~/backups/speaker-20261015-215804.*` |

**Since then (2026-10-16): steps 0 and 1 done and tested on the speaker, local only.** Everything is **committed on `main` but not pushed and not deployed**:
- Backend `47e648a` (step 0, calling fix) and `667276f` (step 1, a new audio link closes the old one). **68 e2e tests pass.**
- Firmware **0.30.2** (`led-demo` `3188aa8`): no freeze after uploads, more open files allowed, failed audio-link retries are logged. Plus doc commits after it.
- **B5 (2026-10-17) is built and committed locally too:** see "B5 progress" (backend `053a58a`, web `1d5ee83`; new migration `device_location`; the phone app isn't updated: its API client is not regenerated and it has no place setting yet).
- **B1, B3 (2026-10-16) and B2 (2026-10-17) are built and committed locally too:** (B2: see "B2 progress") backend `ca00b9e` (B1+B3) and `9fbc4c1` (B2) (**86 e2e tests pass**), web `5f6cbd2` (B1+B3) and `8ed3d48` (B2 Routines section), app `a9fb736` (new migrations `notify_settings` and `alarm_label`). Not pushed, not deployed, **not yet tested on the real speaker** (the owner tests in a batch later). See "B1 progress" and "B3 progress" in step 2.
- **Pending tests for the owner (local, on the speaker/phone):** (1) unplug the speaker → an "offline" push after 10 min, "back online" after; set `NOTIFY_OFFLINE_MINUTES=2` in `.env` to see it sooner; (2) Momo: list/change/delete alarms, volume, play a sound by name, delete a sound file, reminder with a reason ("কীসের জন্য?"); (3) web "Say something on the speaker now"; (4) the app needs a **new build** to show the labels and server-side notify settings.
- **Open decisions (owner postponed):** missed-alarm alerts (needs the physical stop button, or B2's ask-and-expect); quiet hours for alerts; whether a label should be required in the apps.
- **False wakes (found 2026-10-16):** in 24 h the wake word opened **79 Momo sessions, about 48 pure false wakes** (TV, other talk, a meeting), each streaming the room's audio to Gemini (cost is small; **privacy is the real issue**: the free tier lets Google use requests). The AI's second check catches most (`not_for_me`), not all. Done: Momo's instructions are stricter (silent unless the first words are clearly the wake phrase) and she no longer volunteers alarms. **Owner decided: leave it for step 5 (the neural wake word).** Until then: untick "Listen for it" on the web Wake word page before meetings, or lower the sensitivity. Optional small fixes if it gets annoying: a "pause wake word for 1 h" button, and automatic backoff after 3 rejected wakes in 10 min.
- **The owner wants a single cloud upload later**, not one per step. When they say "deploy", follow section 2, rule 3:
  - push both repos, back up the server, update the backend;
  - switch `secrets.h` to `mqtts://smart-speaker.duckdns.org:8883` and reflash;
  - then a cloud check: boot log ("Server online", "Audio link up: wss://…"), a 2-minute 📞 Call, and the RAM line on the device page (with TLS it's lower than the local 79 KB free / lowest 68 KB);
  - also read the cloud database's boot events around 22:12 UTC on 2026-10-15, to see whether that dropout was the freeze fixed in 0.30.2.
  The owner must switch Claude Code to "Ask before edits" first: auto mode refuses ssh to the server, both commands and database reads.
- **The speaker is on 0.30.2 with the local setup** (`secrets.h` → `mqtt://192.168.0.109:1883`). Keep it local while building step 2.
- The PC's LAN address changed from .103 to **.109**. Check `ipconfig` each time.
- A stale phone session was deleted from the **local** database only (Kashem's). See "Lessons from step 0".
- **Serial log without resetting the speaker:** `arduino-cli monitor` captured nothing. Use a PowerShell `System.IO.Ports.SerialPort` reader with `DtrEnable`/`RtsEnable` off that reopens the port when it goes away (it survives unplugging). Don't keep the port open while flashing.
- **Boot reasons are in the database** (`Event`, `type='boot'`, `data.reason`: `froze`, `crash` with a backtrace, `usb_reset`, `power_on`…). Check them first when the speaker went offline. Decode a backtrace with `xtensa-esp32s3-elf-addr2line -pfiaC -e <the build's .elf>`. The ELF must be from the same build; `./fw.sh build` writes it to `firmware/build/s3/`.

**Decided and closed:**
- **Interrupting Momo by voice (barge-in): not wanted.** It was built and tried, then switched off (`BARGE_IN 0` in `firmware/config.h`). Momo stopped on her own echo and on room noise. Don't bring it back, not even by wake word, unless the owner asks.
- Echo cancellation runs in **FD low-cost mode** in PSRAM. It's created once at boot.
- **Scope cut (2026-10-16): the owner has exams and other work, so these are skipped for now:** #6 emergency help button, #30 multi-speaker help request, #18 smart home, #26 news briefing, #24 announcements across rooms, #7 offline commands (**step 4 is postponed**). #8 was already skipped. Don't build them unless the owner brings them back. Keep each piece of work small, and check with the owner before starting a feature.
- The delay on live audio (about 1 s speaker → phone) is **acceptable to the owner**: leave the buffers as they are.
- **Stopping or snoozing a ringing alarm by voice: skipped.** The speaker ignores the mic while it makes sound, so it would need the alarm to ring in bursts and listen for the wake word in the gaps. Too much complexity for now. **Later the owner plans physical buttons:** stop/snooze, emergency help, and start the voice assistant. Until then, alarms stop from the app/web, or by themselves after 60 s.

**Not committed (leave alone):** `led-demo/hardware/kicad/`. The owner said the KiCad schematic isn't needed.

---

## 2. How we work (rules)

1. **Test locally first, then the cloud.** The owner tests on the real speaker before any cloud deploy.
   - Backend: `cd smart-speaker-backend && npm run start:dev` (port 4000).
   - Web: `cd smart-speaker-web && npm run dev -- --host`.
   - Speaker: in `firmware/secrets.h` (git-ignored), switch `MQTT_URI` to the local line `mqtt://<this PC's IP>:1883` (check `ipconfig`: it was .103, then .109 on 2026-10-16), then `./fw.sh upload COM11` from `led-demo/firmware`.
2. **Local is plain (`mqtt://`, `ws://`), the cloud is encrypted (`mqtts://`, `wss://`).** Problems that only happen with TLS, such as running out of internal RAM, show up **only on the cloud**. After every cloud reflash, read the boot log. You should see "Server online" and "Audio link up: wss://…".
3. **Cloud deploy** (each step needs the owner's go-ahead):
   - back up the database and files;
   - `git archive --format=tar HEAD | ssh … 'tar -x -C ~/speaker'`;
   - `docker compose -f docker-compose.prod.yml up -d --build backend`;
   - upload the web `dist`;
   - set `secrets.h` back to the cloud URI and reflash.

   Details are in the assistant's memory file `cloud-deploy.md`. Never overwrite the server's `.env` or `certs/`.
4. **Secrets:** never print the Gemini key. `secrets.h`, `.env` and the Firebase key stay git-ignored.
5. **Serial log:** COM11 at 115200. Stop any log capture before flashing (the port is busy otherwise).
6. **Firmware edits:** use the Edit tool for C strings. Python heredocs in Git Bash turned `\n` into real line breaks several times.
7. **Web first (owner, 2026-10-17):** every new feature ships with a web UI in the same piece of work, so the owner can test by clicking, not with Swagger or curl. The phone app comes after. Regenerate the web client with `npm run api`.

---

## 3. What we measured (keep for reference)

| What | Result |
|---|---|
| Opus vs raw audio | about **1/10 of the data** (34–68 KB/min vs 300–440 KB) |
| Network to the cloud | about **55 ms** round trip (Singapore) |
| Echo of the speaker at the mic | loud: **−11 dBFS** at 4 kHz, −25 to −33 dBFS for the low and middle notes |
| Echo canceller (sweep test) | removes **15–30 dB**. A person's voice over the sound is kept. |
| Echo canceller cost | **10.1 ms CPU per 32 ms** chunk (FD low-cost; high-perf 13.6 ms). About 142 KB of PSRAM, about 9–13 KB of internal RAM. |
| Echo delay | stable across reboots: `snap` −9408, `AEC_DELAY_CAL` 1318. The canceller's own output delay is 1024 samples (64 ms). |
| Internal RAM | 0.30.2, local setup, after a 10-minute call: **79 KB free, lowest 68 KB** since boot (earlier builds: about 49 KB at idle). The cloud (two TLS sessions) leaves less: measure it after the deploy. Watch it on every change that touches Wi-Fi or TLS. |
| Hear the room (📞 Call) | 10 min with no samples lost; about 160 KB a minute of Opus over the link |

---

## 4. Feature reality (checked in the code, 2026-10-16)

A feature list claimed 13 features were "done" and 12 needed "a small change". It was checked against the backend, web, app and firmware. **Only 4 of the 13 "done" items really work end to end**, and most "small change" items aren't built at all. Start from this table, not from that list.

Key: ✅ works today · 🟡 partly there · ❌ not built

### Claimed "done"
| Feature | Reality | What exists / what's missing |
|---|---|---|
| Medication reminder | 🟡 | Reminders work: by voice (Momo `set_reminder` → spoken "মনে করিয়ে দিচ্ছি: …" WAV) or from web/app with a recorded message. **Missing:** no label stored (`Alarm` has no label column), no "ওষুধ খেয়েছেন?" check, no family alert |
| Voice-controlled family calling | ✅ | `call_family` → push + call screen on the phone. Fixed in step 0: if no phone or open app got it, Momo says she couldn't reach them; otherwise "খবর পাঠিয়েছি", never "ringing" |
| Companionship / conversation | ✅ basic | Momo chats in Bangla. Short answers, 180 s cap, **no memory between conversations**, owner account only |
| Prayer-time and routine assistant | ❌ | No prayer times, azan or location. Routines are only alarms set by hand |
| Hydration / activity reminders | 🟡 | Only as ordinary repeating reminders set by hand |
| Remote caregiver routine management | ✅ | Family members (not only the owner) can add, edit and delete alarms and record messages, on web and app |
| Bangla speech failure and recovery | 🟡 | Momo asks again; says "এখন বুঝতে পারছি না" if the AI is down. **Silent** if the session drops mid-talk, and **silent** after the wake word when the internet is down |
| Family circle and special-day greetings | 🟡 | The family circle exists (members, roles, call names). No birthdays or greetings |
| Device health and caregiver dashboard | 🟡 | Technical health is live for all members (RAM, CPU, Wi-Fi, crashes). No caregiver view (activity, missed alarms). The app's "speaker offline / restarted / missed alarm" toggles are saved on the phone only and **do nothing** |
| Family presence mode | ❌ | Nothing. "Presence" in the code only means the speaker is online |
| Family announcement across the home | 🟡 | Hold-to-talk to **one** speaker at a time |
| Reminder confirmation and correction | 🟡 | Momo reads the time back; can cancel only the reminder just set. Can't list or change reminders by voice |
| "Repeat and explain" | 🟡 | Not a feature. Momo may do it as normal chat; untested |

### Claimed "a small change makes it work"
| Feature | Reality | Honest size |
|---|---|---|
| Morning greeting and daily plan | ❌ nothing proactive; talks start only from the wake word or a button | medium |
| Family voice messages | 🟡 record a message as a reminder, or upload a file and play it | **small** ("send a message now") |
| Scheduled wellbeing check-ins | ❌ | medium (the server starts a conversation at set times; the speaker already supports it) |
| Emergency help button | ❌ the speaker has **no buttons at all** (no input pins); voice "call family" is the only substitute | hardware + firmware + push |
| Internet loss and offline mode | 🟡 alarms and stored tones work offline, but **only once the clock is set**. Firmware 0.31.x reads a DS3231 clock module at boot (GPIO 21/47), so with one fitted, alarms ring after a power cut without internet (not yet tested on hardware). Without it, alarms stay silent until NTP. No feedback after the wake word; no offline commands | medium–large (step 4) |
| Bangla stories, poetry, culture | 🟡 chat only; the "one or two sentences" rule and the 180 s cap block real stories | **small** (a story mode) |
| Lost-item memory | ❌ | medium |
| Appointment and schedule assistant | 🟡 one-time reminders on a date | small–medium |
| Missed check-in and caregiver escalation | ❌ no acknowledgement or missed-alarm tracking, no push | medium |
| Personalised speech preferences | ❌ Momo's voice is one server-wide setting (`GEMINI_VOICE`); Bangla fixed; no speed | small–medium |
| Daily memory and personal notes | ❌ transcripts are saved but only the owner can read them; Momo never uses them | medium |
| Gentle reminder to contact family | 🟡 only as a reminder set by hand | small |

### Gaps the list doesn't mention
- **Phone app:** no Momo, wake word or voice-log screens (web only).
- **Voice log:** visible to the owner only.

### Honest small wins
These are the cheapest real improvements. Each comes early in the building blocks of step 2:
- offline / restarted / missed-alarm **push alerts**: the app toggles already exist, and the backend just has to send them (B1);
- a **label** on reminders, shown in the apps (B3);
- voice message **"send now"** (B3);
- a **"contact your family" nudge** (a B2 template);
- Momo **story mode** (instructions only).

---

## 5. The plan, in order

### Step 0: Fix the calling bug ✅ done 2026-10-16 (backend `47e648a`, local only)
- `FamilyService.call` returns `{ phones, apps }`: the phones the push went to, and the open pages or apps that got the live call (`RealtimeGateway.toUser` now returns that count).
- `call_family` with neither answers `{ ok: false, problem: "their phone can't get calls right now" }`, and the conversation isn't logged as `called`.
- When it goes, Momo is told `{ ok: true, sent, note }` and says "…কে খবর পাঠিয়েছি, উনি দেখলে কল করবেন". She never says the phone is ringing.
- New e2e case: a member with no app and no page. The owner tested both cases on the speaker.

**Lessons from step 0 (open follow-ups, not done):**
- "Reached" means **Google accepted the push**, not that the phone showed it. An old login with a stale token still counts. Kashem had a phone-app session from 2026-10-15 that was never logged out, so his calls "went".
- **Follow-up A (small):** when the phone app switches account, it should log out the old session, so that phone stops getting the old person's calls. Check `smart-speaker-app`'s login and logout flow.
- **Follow-up B (medium, fits B1):** a delivery receipt. The app tells the server when a call notification arrives, and Momo waits about 5 s before saying "it reached them".

### Step 1: Stability check ✅ done locally 2026-10-16 (firmware 0.30.2, backend `667276f`); the cloud check comes with the single deploy
Three loose ends from the deploy. One test session with the owner covers all three.

**Progress 2026-10-16: committed, not pushed, not deployed** (firmware 0.30.2 `led-demo` `3188aa8`, backend `667276f`, on top of step 0's `47e648a`). The cloud upload happens once, together with step 0:
- **Found: the speaker "froze" (watchdog restart) about 12 s after nearly every upload**, from 0.27 to 0.30.1. The boot events in the local database show it: `usb_reset`, then `froze` (task `IDLE1`, pc `0x40380107` = core 1 idle). Cause: with USB plugged into the PC and no serial monitor reading, the core's USB serial (`HWCDC`) waits up to 2 s per print (core messages 100 ms per character), so a few prints in one `loop()` pass trip the 5 s loop watchdog. After `power_on` it didn't happen. **Fix (firmware 0.30.2):** `Serial.setTxTimeoutMs(1)` in `setup()`. Flashed twice with no monitor open: no freeze.
- **The 16:29:56 offline/online on 2026-10-16 was that freeze**, not Wi-Fi. The "audio link down" at 16:30:01 was the *old* link (the dead one from before the restart) being found by the server's 20 s ping. The new link stayed up, so the link *did* come back. The backend now closes an old link as soon as a new one from the same speaker logs in, and logs "old audio link closed (a new one replaced it)". New e2e case in `audio-link.e2e-spec.ts` (**68 e2e tests pass**).
- The firmware now logs a failed audio-link attempt ("couldn't connect", "the server didn't accept the login"): the first one, then about once a minute. Before, failed retries were silent.
- **"Too many open files": found.** FFat and the SD card were mounted with **2 open files at most**. A ringing tone + a tone download already use 2, so any third `open`/`exists` failed with ENFILE. No `File` was left open anywhere. Now `FFAT_MAX_FILES` 6 and `SD_MAX_FILES` 4 (`config.h`); the slots are in PSRAM (`CONFIG_FATFS_ALLOC_PREFER_EXTRAM`), so no internal RAM is used.
- **Tested with the owner on the speaker (local, 0.30.2), 2026-10-16:**
  - No restart for 2 h 44 m. The audio link stayed up the whole time.
  - Hear the room (📞 Call) ran the full 10 min (19:31–19:41) with no dropout: 9,600,000 samples (600 s, none lost), 157–165 KB a minute over the link.
  - RAM: 79 KB free, lowest 68 KB since boot (local; check again on the cloud with TLS).
  - Delay: speaker → phone about 1 s at most. **The owner finds it acceptable**, so the buffers stay as they are.
  - Unplugged while an alarm rang: back online in 5 s, the alarm rang again in the same minute, no file errors (while the page listed files at the same time).
- **Open:** was the cloud dropout at 22:12 UTC on 2026-10-15 the same freeze? Check the cloud database's boot events around then (`Event`, `type='boot'`). If it was `froze`, it's fixed; if there's no boot, it was the network.

1. **Dropout during "Hear the room".** At 22:12 UTC on 2026-10-15 the speaker went offline for about 2 s during a listen session, then came back. Was it a restart or Wi-Fi?
   - Record the serial log (no reset) while the owner uses Hear the room for 2–3 minutes. Look for `rst:`, `Guru`, `abort`, "audio link down".
   - Also check the free internal RAM in the stats module during a listen session.
   - If it's a crash, fix the cause. If it's the link, check the heartbeat (20 s ping) and the `MAX_BUFFERED` (64 KB) close.
2. **"A bit of delay" on live audio.** ✅ Addressed by the audio plan, phase 1 (2026-10-18): `PLAY_RING` 1024, a 125 ms prebuffer, no 125 ms batching on the audio link, a catching-up player in the apps; the link watchdog covers the link that didn't come back. See [AUDIO_PLAN.md](AUDIO_PLAN.md). Ask the owner which direction is late, and by how much.
   - Expected total is about 0.4–0.6 s.
   - **Easy win:** 0.29 added a 128 ms play ring plus 4 DMA buffers, about 64 ms more output delay. Try `PLAY_RING` 1024 in `audio.cpp` and check for underruns.
   - Other knobs: `TALK_PREBUFFER` (190 ms) in `config.h`; mic pieces of 120 ms (`PIECE` in `mic.cpp`); the app's playback buffer.
   - **Seen again on 2026-10-16 (local):** right after a boot, the speaker went offline and online once (16:29:56), then the audio link went down at 16:30:01 and **didn't come back** until the backend restarted about 10 minutes later. Conversations fell back to MQTT audio meanwhile. Check the firmware's reconnect logic in `audiolink.cpp`: after "link down", does it retry?
3. **"Too many open files" once at boot** while an alarm was ringing (FFat `fopen` failed, ENFILE 23). Find which code keeps files open: the tone cache check at boot (`tonecache.cpp`), alarm playback (`audio.cpp`), or `files.cpp`. Make sure every `File` is closed.

**Done when:** Hear the room runs 10 minutes without a dropout, the delay is acceptable to the owner, and a boot with an alarm ringing shows no file errors.

### Step 2: Five building blocks, not 25 features
The owner's rule: use cases must be **dynamic**, so new ones take little effort. Almost every item in section 4 is a combination of the same few parts. So build **five building blocks** once, then each use case is a **template**: settings the family turns on and edits in the app, not new code.

**B1. Notifier: tell the family.** One service decides who gets told, how (push now; SMS later) and how often (quiet hours, no repeats).
- Settings are per family member, on the server. Move the app's Account toggles (`smart-speaker-app/app/(tabs)/account.tsx:53-73`), which today are saved on the phone only.
- Event sources, all already in the bridge (`device-bridge.service.ts`): speaker offline for N minutes, speaker restarted or crashed, alarm fired; later routine results and "help".
- Reuses `PushService` and `FamilyService`.

**B2. Routines: the speaker starts something on its own.** One table and one scheduler. A routine is *when* + *what Momo does* + *what to expect* + *what if not*:
- **When:** a time with repeat days, a date (yearly for birthdays), the prayer times of the day, or an event (alarm fired, morning first alarm, no conversation for N days).
- **What:** play a sound or recorded message; Momo says a sentence; or Momo **asks** and listens (a short conversation, started by the server. The speaker already supports this: `mic_record` with `conversation`).
- **Expect:** nothing, a yes/no, or any answer (Momo gets a tool `routine_answer(ok, note)`).
- **If not:** ask again after M minutes (up to K times), then tell the family through B1 ("আম্মা সকালের ওষুধের উত্তর দেননি").
- Every run is logged (who answered what, when), and that log *is* the caregiver dashboard.

**B3. Speaker tools: one tool set used by Momo and the apps.** Everything the speaker can do, as service calls that both the apps (API) and Momo (tools) use:
- alarms: `list_alarms`, `set_reminder` with a **label** (new `Alarm.label` column) and a **tone/song** by name, `change_alarm`, `delete_alarm`;
- sound: `play_music` / `stop_music`, volume;
- messages: `send_message` (play now, or at a time), `announce` (several speakers at once);
- family: `call_family` (fixed in step 0), `routine_*` (add, change, pause a routine by voice: "রোজ রাত ৯টায় ওষুধের কথা জিজ্ঞেস করো").

**B4. Memory: Momo remembers.** One small table of notes per speaker: `kind` (note, item_place, preference, person, summary), text, time.
- Tools: `remember(kind, text)`, `recall(question)`.
- At the start of each conversation, Momo gets the preferences ("আম্মা বলে ডাকবে", "slow, loud") and a short summary of recent talks.
- After each conversation, a one-line summary is saved (from the existing `VoiceLog` transcript).
- The family can see, edit and delete the notes in the app (privacy).

**B5. Context: what Momo and routines know right now.** One function builds a short context block used by Momo's instructions and by routine sentences:
- now (date, Bangla calendar day), today's and the next alarms with labels;
- weather (free API, by the speaker's location: add `Device.location`);
- prayer times (calculated from location, e.g. the `adhan` library: no API needed);
- family special days, and who called recently.

**What each use case becomes:**
| Use case | Built from |
|---|---|
| Medication reminder + "did you take it?" + family alert | B2 (ask, expect yes, then B1) + B3 label |
| Hydration and gentle activity | B2 (say, every 2 h, daytime) |
| Wellbeing check-in, missed check-in escalation | B2 (ask any, then B1) |
| Morning greeting and daily plan | B2 (event: first alarm) + B5 (weather, today's reminders) |
| Prayer-time / Azan | B2 (prayer times) + B5 (location) + an Azan tone |
| Special-day greetings | B2 (yearly date) + B5 (family days) |
| Gentle reminder to contact family | B2 (event: no call for N days) + B3 `call_family` |
| Appointments | B3 label + B2 (date + reminder the day before) |
| Reminder confirmation and correction | B3 (`list_alarms`, `change_alarm`) |
| Lost items, daily notes, personal preferences, companionship memory | B4 |
| Family voice messages | B3 (`send_message`); `announce` to several speakers is skipped for now |
| Device health alerts, caregiver dashboard | B1 + the B2 run log |
| Remote caregiver routine management | the apps over B2 and B3 (already partly true for alarms) |
| Stories and poetry | a Momo "story mode" (longer answers when asked; instructions only) |
| ~~Emergency help~~ | ⏸ skipped for now (scope cut). Later: B1 (urgent) + a trigger: voice ("বাঁচাও" / "সাহায্য"), then a hardware button |

**B3 progress (2026-10-16): built, e2e-tested, committed locally (backend `ca00b9e`, web `5f6cbd2`, app `a9fb736`). Waiting for the owner's local test on the speaker.**
- **Alarm label:** new `Alarm.label` column (migration `alarm_label`), set from web and app (a "For" field, shown on the list and cards). Momo's reminders save it.
- **Momo knows the speaker:** at the start of each conversation her instructions list the speaker's name, volume and every alarm (number, kind, what for, when, on/off).
- **New Momo tools:** `list_alarms`, `change_alarm` (time/day/on-off, by number n), `delete_alarm`, `set_volume` (louder/quieter by 20, or level 1-10), `play_sound` (a tone, song or file by name; it starts when the conversation ends, because the speaker can't play while it listens). New voice results `alarm_changed`, `alarm_deleted`, `played`.
- **Reminder sounds are named after what they say** (`/Reminders/প্রেসারের ওষুধ.wav`, not a timestamp). The same reminder again reuses the file (no new AI speech); users delete unwanted ones in the file manager (built-in storage, /Reminders). Deleting an alarm does **not** delete its sound file.
- **Voice message "send now":** `POST /devices/:id/files/message` (a recording; plays at once after a short chime, not stored). Web: "Say something on the speaker now" under Alarms. **Not in the app yet** (needs an audio-recording package; the app already records for alarms, so reuse that later).
- **Deleting by voice (fixed after the owner's test):** Momo said she'd deleted a reminder sound or tone but hadn't: `delete_alarm` only removes the alarm. Now `delete_alarm` tells her the sound file stays (or removes it too with `with_sound`, if no other alarm uses it), and a new `delete_sound` tool deletes a file on the speaker by name (alarms that played it switch off). Her instructions say never to claim a deletion the tool didn't confirm. Tones from the server's library (built-in tones) aren't files on the speaker and can't be deleted by voice.
- **Reasons on alarms:** Momo now asks "কীসের জন্য?" when no reason is given and saves it as the label. A label is still optional in the apps.
- **Test note:** the first e2e run after any code change often fails some suites in setup (cold ts-jest compile is slow); run again.
- **Not done in B3:** `announce` to several speakers (skipped by scope), `send_message` at a time (use an alarm with a recorded message), reminder "tone/song by name" on `set_reminder`, stop/snooze by voice (skipped).
- **Open question:** `set_volume` reads the speaker's last reported volume (0-100); if the speaker hasn't reported one it assumes 50. The firmware's real volume scale hasn't been checked on the speaker.

**B2 progress (2026-10-17): smallest useful version built, e2e-tested, with a web UI, committed locally (backend `9fbc4c1`, web `8ed3d48`). Not pushed, not deployed, not yet tested on the real speaker.**
- **What it does:** a *routine* is a time + repeat days (empty = every day) + `say` (Momo says a sentence) or `ask` (Momo asks it and listens). `expect`: `yes` (they did it) or `any` (any answer counts). No answer or "not yet" → ask again after `retryMinutes`, `retries` more times, then a push to the family (`alertFamily`). Every go is a `RoutineRun`; `GET /devices/:id/routines/runs` is the caregiver log.
- **API:** `devices/:id/routines` (list, create, PATCH, DELETE; any family member), `POST …/:routineId/run` ("try it now": a manual run, 409 if it's still going), `GET …/runs`. **Web:** a "Routines" section on the device page under Alarms (`src/pages/device/Routines.tsx`): add (ask/say, time, days, wants yes or any answer, tries, minutes apart, tell the family), switch on/off, delete, **▶ Run now**, and a "What happened" log that refreshes every 5 s. Plus a "A routine got no answer" toggle in Notify me. **No edit-in-place** (delete and add again). **No app screen yet** (web first, see rule 7).
- **Code:** `src/routines/` (service with a 30 s tick, `ROUTINE_TICK_SECONDS=0` turns the timer off in tests, which call `tick(at)` and `idle()`); `VoiceService.ask(…, 'routine', {question, expect})` says the question, then opens the conversation with a `routine_answer(ok, note)` tool; `VoiceService.announce` for `say`. New push kind `routines` (default on) in `NotifySetting` / `GET|PATCH /notify`. New tables `Routine`, `RoutineRun` (migration `routines`). Voice log gets triggers/results `routine`, `said`, `routine_answered`.
- **Rules:** a routine runs only within 5 min after its time (a late server doesn't fire hours later) and once per day (manual runs don't count). The speaker busy in a conversation or a mic test → looked at again after 1 min, no try used, skipped after 30 min. Speaker offline → run `offline`, no alert (B1 already alerts). A server restart marks a run that was talking `failed`.
- **Tests:** `test/routines.e2e-spec.ts` (9 cases); **86 e2e tests pass** in total.
- **Not in B2 (later):** yearly dates, prayer times, event triggers (alarm fired, no call for N days), Momo `routine_*` voice tools, playing a recorded sound, quiet hours. Check with the owner before adding any.
- **Pending test for the owner (local):** open the speaker's page → **Routines** → add an "Asks and listens" routine (e.g. `ওষুধ খেয়েছেন?`, 2 tries, 1 min apart), **▶ Run now**, answer "yes"; run it again and stay silent to see "asking again soon", then "no answer · family told" and the push. Also try "Just says". Claude only type-checked it and checked that Vite serves it; nobody has clicked through it in a browser yet.
- **Local setup:** the backend was restarted after the migration and `prisma generate` (the engine DLL is locked while the dev server runs: stop it first if `prisma generate` says EPERM). **The dev server was started from Claude's session and may be stopped now: start it with `npm run start:dev` in `smart-speaker-backend`, and the web with `npm run dev -- --host` in `smart-speaker-web`.** After backend API changes, run `npm run api` in the web project (the backend must be running).

**Next: step 3** (B4 is built, see "B4 progress"). (B2 notes, kept: B1's `NotifyService` (`src/notify/`) is the "tell the family" part; B3's Momo tools and alarm helpers are in `src/voice/voice.service.ts` (`act`, `alarmsNow`, `planFrom`/`newWhen`, `findSound`). A routine that "asks and listens" needs the server to start a conversation (`VoiceService.ask` today needs an owner id and the speaker to be free: `busy`). Keep it to the smallest useful version (one table, one scheduler, a run log) and check with the owner before adding more.)

**B5 progress (2026-10-17): built, e2e-tested, with a web UI, committed locally (backend `053a58a`, web `1d5ee83`). Not pushed, not deployed, not yet tested on the real speaker.**
- **What Momo and routines now know:** the date in Bangla (the Bangladesh 2019 calendar, `src/context/bongabdo.ts`: 17 Oct 2026 = ২ কার্তিক ১৪৩৩; 1 Kartik is 16 Oct), the weather (Open-Meteo, no key, kept 30 min; slow or down = left out, never blocks), today's five prayer times and the next one (`adhan`, Karachi method, Hanafi asr; Friday shows জুম্মা), and the next alarm.
- **Where the speaker is:** new `Device.place/latitude/longitude` (migration `device_location`); `PATCH /devices/:id` takes `location: { place, latitude, longitude } | null`. Web: **Settings → Place** (search a town with Find, pick, Save; Clear). Without a place there is no weather or prayer times; the date and alarms still work.
- **Momo:** `instructions()` (`src/voice/momo.ts`) gets the context: the Bangla date, weather and prayer-time lines, and a rule: use them only when asked or when chatting about them, never bring up prayer times on her own.
- **Routine sentences:** `{date}` `{weather}` `{next_prayer}` `{next_alarm}` are filled when the routine runs (`ContextService.fill`); what isn't known is left out and the punctuation tidied; a sentence that ends up empty fails the run ("Nothing left to say"). A filled sentence's speech is not kept on disk (it would never be used again). The log and the family's push keep the text as written. Web: chips under the sentence field and a "It would say now" preview.
- **API:** `GET /devices/:id/context` (any family member: date, weather, prayers, next alarm and the placeholder phrases), `GET /places?q=` (town search).
- **Web:** a **"Today on this speaker"** box above Routines shows the same things.
- **Tests:** `test/context.e2e-spec.ts` (8 cases, fake weather service; the Bangla calendar incl. a leap year, location checks, the phrases, Momo's instructions, routine sentences). **94 e2e tests pass** when the setup race below doesn't hit.
- **Test pitfall found:** the test database is shared by all suites and `RoutinesService.tick()` looks at **every** routine in it, so a suite that calls `tick` can start another suite's routine. The new tests use the manual "Run now" on a disabled routine instead.
- **Known flake (not from B5):** under parallel load a suite's setup sometimes fails with a 500 on `POST /devices/claim`: the speaker's first connect and the claim both `upsert` the new `Device` row and one loses ("Unique constraint failed on the fields: (`id`)"). The suite fails as a whole; run again. Worth a small fix (catch and retry the upsert) when time allows.
- **Not in B5:** family special days (birthdays) and "who called recently": nothing stores them (no birthday field; calls aren't logged anywhere), so they need new tables, web UI and a call log. Say so to the owner before adding. A "place" is per speaker; the time zone is still set by hand.
- **Pending test for the owner (local):** (1) speaker page → Settings → Place: search "Dhaka", pick, Save; the **Today** box shows the Bangla date, weather and prayer times (compare with a prayer app: Bangladesh times differ by a minute or two between sources); (2) add a "Just says" routine `শুভ সকাল! আজ {date}। {weather}। {next_prayer}।` and **▶ Run now**: the speaker should say it; (3) ask Momo "আজ বাংলা কত তারিখ?", "আসরের ওয়াক্ত কখন?", "আজ বৃষ্টি হবে?"; she shouldn't mention prayer times unasked.
- **Lesson: restarting the backend can leave the speaker showing offline (2026-10-17).** After a quick restart the hub's first MQTT logins are refused for about 5 s; the speaker's `hello` arrived in that window and was missed, and the speaker won't say hello again (the retained `ss/server/online` stayed `1`). Fix: publish `0` then `1` (retained) to `ss/server/online` on the local broker, or restart the backend once more; stop it with Ctrl+C, not a force-kill. Documented in `protocol.md`. A small code fix when there's time: once the hub's MQTT is connected, republish `0` then `1`, so every speaker says hello again.
- **Local setup note:** the backend dev server (`nest start --watch`) was stopped from Claude's session for `prisma generate` (EPERM otherwise) and restarted in the background from there; it may be stopped when the session ends: `npm run start:dev` again.

**B4 progress (2026-10-17): smallest version built, e2e-tested, with a web UI, committed locally. Not pushed, not deployed, not yet tested on the real speaker.**
- **Scope the owner chose (to keep Gemini calls and tokens down):** **no summary after each conversation** (it would be one more Gemini call per session, about 79 wake sessions a day) and **nothing added to Momo's start-of-conversation instructions**. So there are no extra Gemini calls: `remember` and `recall` are tools inside the conversation that is already open, and `recall` is a plain word search in Postgres (no AI, no embeddings). Every family member can see, add, edit and delete notes.
- **Backend:** new `Note` table (migration `notes`: `deviceId`, `kind` = `note | item_place | preference | person`, `text` up to 200 characters, `source` = `voice | app`, times; at most 300 per speaker). `src/memory/` has `MemoryService`, and `GET / POST / PATCH / DELETE /devices/:id/notes`. Two new Momo tools in `momo.ts`, run in `voice.service.ts` `act()`: `remember(kind, text, item?)` (for `item_place` with `item`, the thing's old place is replaced, so each thing has one place) and `recall(about, kind?)` (matches words, also across Bangla endings: চশমাটা finds চশমা; with no match it returns the newest 10 notes so she can judge). Momo is told the tool's real result, and her tool text says never to claim a save the tool didn't confirm. New voice result `remembered`.
- **Cost of it:** the two tool descriptions add a few dozen tokens to every conversation's setup. Nothing else.
- **Web:** a **"What Momo remembers"** section on the speaker page under Routines (`src/pages/device/Memory.tsx`): notes grouped by kind, add, edit in place (Enter saves, Esc cancels), delete. The voice log shows "🧠 Remembered something". **No phone app screen yet.**
- **Preferences are not injected.** "Call me আম্মা" is saved, but Momo only uses it when she looks notes up. If the owner wants her to always use a preferred name, the cheapest way is a few preference lines in `instructions()` (a small cost on every conversation): decide later.
- **Tests:** `test/memory.e2e-spec.ts` (5 cases: remember and replace, bad input, empty memory, the instructions hold no notes, family access and a stranger's 404). **99 e2e tests pass** (the third run in a row; two runs lost a whole other suite to the known setup flake below).
- **Known flake, now seen again:** a suite's setup fails with a 500 on `POST /devices/claim` ("Unique constraint failed on the fields: (`id`)" in `DevicesService.bind`): the speaker's first connect and the claim both `upsert` the new `Device` row. Worth the small fix (catch and retry the upsert) when time allows.
- **Local setup:** Docker Desktop wasn't running: it was started, with only `smart-speaker-backend-db-1` and `smart-speaker-backend-mqtt-1`. The migration is applied to the local `speaker` database. The backend dev server and Vite (`--host`) were started from Claude's session; if the speaker shows offline after the backend restarted, see "Lesson: restarting the backend" in B5 progress.
- **Pending test for the owner (local):** (1) say "হাই মোমো, আমার চশমা টেবিলের ড্রয়ারে রাখলাম, মনে রেখো", then in a new conversation "আমার চশমাটা কোথায়?"; (2) "আমাকে আম্মা বলে ডাকবে" should be saved as a preference; (3) speaker page → **What Momo remembers**: the notes show as "said to Momo"; add one, edit one, delete one. Claude only type-checked and built the page (nobody has clicked through it in a browser).
- **Not in B4 (later, check with the owner first):** the after-conversation summary, notes in the start-of-conversation instructions, a voice `forget` tool (the family deletes on the web), the app screen.

**B4 plan (kept for reference; built, see "B4 progress"):**
- **Smallest useful version:** one table `Note` (`deviceId`, `kind`: `note`, `item_place`, `preference`, `person`, `summary`; `text`; `createdAt`), one migration.
- **Momo tools:** `remember(kind, text)` ("আমার চশমা টেবিলে রাখলাম", "আমাকে আম্মা বলে ডাকবে") and `recall(question)`; a Momo tool result says what was saved, and she never claims it saved something the tool didn't confirm (same rule as `delete_sound`).
- **Start of each conversation:** `instructions()` in `src/voice/momo.ts` gets the preferences and the last few summaries, the same way B5 added `context`. Keep it short (a few lines), or the instructions grow every day.
- **After each conversation:** a one-line summary from the `VoiceLog` transcript. This needs one more Gemini call per conversation (small cost, and the free tier lets Google use requests, see the privacy note in section 1): ask the owner whether to do it, or to start with `remember` only.
- **Privacy:** the family sees, edits and deletes the notes. Web first (rule 7): a "What Momo remembers" section on the speaker page (list, add, edit, delete; grouped by kind), then the app. Who may see: the owner only, or every family member? Ask.
- **Tests:** `test/memory.e2e-spec.ts` with the fake AI (tools saved, instructions contain the notes, delete removes it, family access). Use the manual "Run now" and your own device: the test database is shared and other suites' ticks interfere (see B5 progress).
- **Then step 3** (Care routines templates, see below), which reuses B2 routines and B5 placeholders.

**Order:** B1 → B3 → B2 → B5 → B4. B1 and B3 are small and useful on their own; B2 needs both. Each block gets backend e2e tests (fake AI and fake speaker, as in `test/voice.e2e-spec.ts`) and a local test with the owner before the cloud.

**Time and scope (agreed 2026-10-16):** the owner has exams and other work, so keep each block to its smallest useful version. The owner told their supervisor **about 1 week** for steps 2 and 3, with first results in 2–3 days (B1 alerts and B3 voice tools: list, change and delete reminders by voice, voice messages). Rough split: B1 + B3 about 2 days, B2 + B5 2–3 days, B4 1 day, the Care routines page 1–2 days. Check with the owner before adding anything beyond that.

**Where the use cases stand:** 23 are in scope (29 minus the six skipped). Today 3 work ✅, 13 partly 🟡, 7 are not built ❌: about 40%. The supervisor was told this on 2026-10-16.

**B1 plan (kept for reference; built, see "B1 progress"):**
- **Settings on the server:** a per-member table (e.g. `NotifySetting`: userId, deviceId, offline, restarted, missedAlarm, quiet hours). It replaces the phone-only toggles in `smart-speaker-app/app/(tabs)/account.tsx:53-73`, and an API lets web and app read and change it.
- **Events:** speaker offline for N minutes (with a timer, so a short blip or a restart doesn't alert); a `boot` with reason `froze`/`crash`/`brownout`; an alarm that rang with nobody stopping it. Note: the speaker sends `alarm_fired`, then `stopped`. It stops by itself after `RING_MAX_MS` (60 s) and sends the **same** `stopped` as when a person stops it. So "missed" needs a small firmware change: `stopped` with a reason (`timeout` vs `user`). The app's toggles are "Missed alarms", "Speaker offline (after 10 minutes)" and "Speaker restarted".
- **Sending:** through `PushService` to the members who turned it on, with no repeats within a time window.
- **Tests:** an e2e test per event with the fake speaker; then a local test with the owner (unplug the speaker → a push on the phone after N minutes).

**B1 progress (2026-10-16): built, committed locally (same commits as B3). Waiting for the owner's local test.**
- **Backend:** new `NotifySetting` table (migration `notify_settings`) and `src/notify/` (`NotifyService`, `GET / PATCH /api/v1/notify`). Settings are **per person, for all their speakers** (like the app's Account toggles), not per speaker. Defaults: doorbell on, offline on, restarted off.
  - **Offline:** an alert after `NOTIFY_OFFLINE_MINUTES` (10) offline, then "back online" to the same people. A restart or a Wi-Fi blip comes back first, so it isn't alerted. The timers live in memory: a server restart forgets a speaker that's already offline.
  - **Restarted:** a boot with reason `froze`, `crash` or `brownout`. Not `power_on`, `restart`, `usb_reset`.
  - **Doorbell:** the visitor push now goes only to members with it on. `PushService.toDevice` is gone.
  - At most one alert of a kind per speaker every 30 min.
  - `test/notify.e2e-spec.ts`: **72 e2e tests pass** (3 runs in a row). Test files must use their own push tokens: registering a token takes it from every other session, and the test database is shared.
- **Web:** a "Notify me" box on the Family tab. **App:** the Account toggles now read and change the server settings (the phone-only `notify` pref is gone), and tapping an offline, online or restarted push opens the speaker. Both API clients regenerated (the app's was well out of date).
- **Missed alarms: not built, needs the owner's decision.** The speaker has no buttons and voice-stop was skipped, so **every** alarm ends by the 60 s timeout unless someone stops it from the app. "Timed out" can't mean "missed" yet. The app's "Missed alarms" toggle was removed. B2's "ask and expect an answer" (e.g. "ওষুধ খেয়েছেন?" then tell the family) is the real check. Alternatively, wait for the physical stop button.
- **Owner's call (2026-10-16): the missed-alarm and quiet-hours decisions can wait; local tests come later, in a batch.**
- **Quiet hours: not part of B1.** The app's "Quiet hours" setting is about a silent doorbell at night, is still phone-only, and does nothing.

### Step 3: Templates in the apps ✅ built 2026-10-17 (backend `abef291`, web `167e2a2`, app `9b77340`), local only
- **Backend:** templates are data in `src/routines/routine-templates.ts` (a new use case is a new entry). `GET /routine-templates` lists them; `Routine.template` (migration `routine_template`) says which template a routine came from, and `POST /routines` accepts `template`. **Five templates:** medicine check (asks, wants a yes, asks again, tells the family), drink water, morning greeting (`{date}`, `{weather}`, `{next_prayer}`), daily check-in (any answer, tells the family if none), call-the-family nudge (daily at 19:00, **only when nobody has called for 3 days**: see below). 100 e2e tests pass (a new case in `routines.e2e-spec.ts`).
- **Web:** a **"Care routines"** section on the speaker page: a card per template with "Turn on" / "Add another", and on each routine an on/off switch, time, words, days, "tell the family", **▶ Run now**, Delete, and **today's result** (answered, no answer · family told…). The old box is now **"Custom routines"** (the ones without a template) with the full run log.
- **App:** two new screens under Settings on the speaker page: **Care routines** (same things: turn on, switch, change time, words and days, run now, delete, today's result) and **What Momo remembers** (list, add, edit, delete). The API client is regenerated. **Needs a new build** (the app was only type-checked).
- **Not templated (need triggers a routine doesn't have):** prayer-time / azan and birthday greetings. Add these when yearly dates and prayer-time triggers exist (see "Not in B2").
- **"No call for N days" (2026-10-17):** new `CallLog` table (migration `call_log`) and `Routine.idleDays` (1-60, null = always). A call is logged when the speaker's call reaches a family member (`FamilyService.call`, by voice or from the app: a phone push or an open app got it) and when a family member starts live talk to the speaker (`talk_start`). \"Hear the room\" listening is not a call. A routine with `idleDays` is skipped (no run, no log line) when any call happened within that many days, checked at its time; manual \"Run now\" ignores it. It also settles the old B5 gap \"who called recently\": the data is there, nothing shows it yet. The log is never pruned (small rows). Web and app Care cards show and edit the number. 101 e2e tests pass.
- **Web page in tabs (2026-10-17):** the speaker page is now Speaker / Schedule / Momo / Family / Device tabs (the tab is kept in the address, `?tab=schedule`), with a divider line between sections. Only type-checked and built: nobody has looked at it in a browser yet.
- **More, 2026-10-17 (backend `5b07c98`, web `4bf42e4`, app):**
  - **Momo sets routines by voice:** one `routines` tool (list, add, change, delete by n; ask or just say; days; on/off). One more tool in every conversation's setup (about a hundred tokens), no extra Gemini calls. Voice results `routine_set`, `routine_changed`, `routine_deleted`.
  - **Call receipts:** a call's id goes with the push and the live event; the called person's app reports it (`POST /calls/:id/seen`) when the notification arrives with the app open or is tapped. An open app or page counts as seen at once. Momo waits up to 4 s (`CALL_SEEN_WAIT_MS`) and says "they've seen it" only then; otherwise "sent". **Limit:** a closed app can't report (Android shows the notification itself), so "not confirmed" is normal, not "missed".
  - **Who called recently:** `GET /devices/:id/family/calls` (to_family / talk, who, seen). Web: "Recent calls" on the Family tab; app: on the Family screen.
  - **Account switch on a phone (follow-up A):** on logout, and when the session runs out, the app deletes its Firebase push token, so any session that still holds it is dead and the next account gets a new one.
  - **Pruning:** routine runs (not ones still going) and calls older than `HISTORY_DAYS` (90) are deleted every 6 h.
  - **Volume scale: checked in the firmware.** 0-100, loudness is `volume² / 10000` (50 = a quarter of full amplitude); the speaker reports it at connect and on every change. `set_volume`'s steps of 20 and levels 1-10 (= 10-100) match. Not tried by voice on the speaker yet.
  - **App:** the speaker's place (Settings → Place: find a town, pick, Clear), a **Voice message** card (record, plays at once after a chime, not kept), the routine run log ("What happened" on Care routines), recent calls. Only type-checked: needs a new build.
  - **Not done:** missed-alarm alerts (wait for the physical buttons: stop alarm, emergency, Momo wake-up, reset); prayer-time and birthday templates.
  - **Momo looks things up (owner, 2026-10-17: "Momo should know everything we have"):** not in her instructions (that costs tokens on every turn), but through `recall` kinds: `calls` (who called or talked), `talks` (earlier conversations), `doorbell` (recent rings), `routine_log` (routine questions and answers), `help` (what the speaker and the apps can do: `HELP` in `momo.ts`, keep it in step with new features), plus the notes. Only the longer tool description is added to every conversation (about 40 tokens).
  - **Fixed: the goodbye said twice.** Momo said goodbye, called `end_conversation`, then answered the tool's result with a second goodbye, which played. Now, if she already spoke in that turn, everything after is dropped and the tool tells her to say nothing more (fewer output tokens too); if she hadn't, her next turn is the goodbye and then it goes quiet.
  - 107 e2e tests pass.

**Small fixes done 2026-10-17 (backend `be7d5c5`):** the `POST /devices/claim` / first-hello upsert race (insert-if-missing, then update), and the hub publishes `ss/server/online` `0` then `1` when its MQTT connects, so a quick backend restart no longer leaves the speaker showing offline (checked live: it came back by itself).

- A **"Care routines"** page (web first, then app) replaces the plain Routines box that B2 already put on the device page. It lists ready-made templates: Medicine check, Drink water, Morning greeting, Prayer times, Daily check-in, Birthday greetings, Call family nudge.
- Each has a few plain settings (times, who to alert, the sentence) and an on/off switch.
- Templates are data (JSON in the backend), so a new use case is a new template, not new code.
- The caregiver view shows today's routine runs: answered, missed, alerted.

### Step 4: Offline basic commands: ⏸ postponed (owner, 2026-10-16)
Skipped for now because of the scope cut in section 1. The plan below stays for later.
Some things must work **without internet**. After "হাই মোমো", if the cloud can't be reached, the speaker handles a few common commands itself.

- **Commands:**
  - what time is it;
  - what day or date is it;
  - volume up / down;
  - stop or snooze the alarm;
  - when is the next alarm;
  - a "no internet right now" reply for anything else.
- **How it hears them:** the same on-speaker matcher as the wake word (DTW, `wakecore.cpp`). Each command has a few takes recorded in the family's voices, using the existing "record a take" flow on the Wake word page.
- **How it answers:** short Bangla clips made by the backend's TTS **while online**, then cached on the speaker (FFat, the same SHA-checked download as tones).
  - Numbers and times are built from pieces, for example "এখন" + "সকাল" + "৮টা" + "১৫ মিনিট".
  - The data for the answers is already on the speaker: the clock (NTP plus time zone), the alarm list, the volume.
- **When:** only when the cloud is unreachable (MQTT down, or the conversation can't start). Online, Momo handles everything as now.
- **Note:** "stop the alarm" *while it rings* means listening during playback. That's the one place the echo canceller is needed. It's separate from interrupting Momo, but check with the owner before building it.
- **Files:**
  - firmware: new `offline.cpp/.h`; `wake.cpp` (command takes beside the wake takes); `mic.cpp`; `tonecache.cpp` (clips);
  - backend: the wake service (command takes) and a clip builder (TTS);
  - web: a commands section on the Wake word page.

**Done when:** with the router's internet unplugged, each command works for the owner 9 times out of 10, and online behaviour is unchanged.

### Step 5: A wake word for the whole family
Today's matcher recognises best the person who recorded the takes. The elderly parent at the speaker is often someone else. **It also wakes on TV, other talk and meetings (about 48 false wakes in 24 h on 2026-10-16), and each one streams audio to Gemini: a trained neural model that stops these on the device is the real fix for that too. Include a false-wake test with Bangla TV and a spoken meeting.**

- **C0 (quick):** up to 3 people × 3 takes. The score is the closest take of anyone.
  - firmware: `wake.cpp` slots, `wake::TAKES` → 9, about 100 KB of PSRAM;
  - web: a person picker on the Wake word page.
- **C1–C5 (bigger, 1.5–2 weeks): a trained neural wake word (microWakeWord).**
  - Synthetic "হাই মোমো" clips from many Gemini voices, plus real family recordings.
  - Bangla negatives (OpenSLR SLR53, Common Voice) and room noise.
  - Train on Colab.
  - Run TFLite Micro on the speaker (esp-tflite-micro and esp-nn are already in the core). The model file lives in FFat, so it can be updated without new firmware.
  - Pass bar: at least 95% detected at 1 m on real family recordings, and at most 0.5 false wakes per hour on Bangla TV and talk.

---

## 6. Useful places

| What | Where |
|---|---|
| Firmware | `led-demo/firmware/`: `mic.cpp` (mic, turns, echo canceller), `audio.cpp` (output, talk, tones), `audiolink.cpp` (WebSocket and Opus), `net.cpp` (Wi-Fi, MQTT, TLS memory), `wake.cpp` / `wakecore.cpp` (wake word), `config.h` (versions and tuning) |
| Build / flash | `cd led-demo/firmware && ./fw.sh upload COM11` (`build`, `monitor` also work) |
| Backend | `smart-speaker-backend/src/`: `hub/` (device hub, audio link), `voice/` (Momo, Gemini live), `mic/`, `common/opus.ts` |
| Backend tests | `npx jest --config test/jest-e2e.json` (fake speaker in `test/helpers.ts`) |
| Message formats | `led-demo/docs/protocol.md` |
| Voice history and milestones | `led-demo/docs/VOICE_PLAN.md` |
| Product roadmap | `led-demo/docs/ROADMAP.md` |
| Architecture page | https://claude.ai/artifact/9NEybBRJFeiws1sWihqnss |
