majharuli0/smart-speaker-esp32/firmware/config.h

// All the settings you might change, in one place.
#pragma once
#include <Arduino.h>  // board definitions (CONFIG_IDF_TARGET_*)

// ---- Firmware version: bump on every release (shown on the web page) ----
#define FW_VERSION "0.37.0"

// ---- Broker address and device secret: in secrets.h, which is not in git ----
#if __has_include("secrets.h")
#include "secrets.h"
#else
#include "secrets.example.h"  // placeholders: builds, but can't connect
#endif
#ifndef DEVICE_SECRET
#error "Add DEVICE_SECRET to secrets.h: the same value as DEVICE_SECRET in the backend's .env"
#endif
#define PROV_NAME_PREFIX "SS-"   // Bluetooth name during Wi-Fi setup + last 4 of the device ID: "SS-09FC"
#define WIFI_RECOVERY_MS (5 * 60 * 1000UL)  // saved Wi-Fi unreachable this long: open Bluetooth setup too

// ---- Time ----
#define NTP_SERVER_1 "pool.ntp.org"
#define NTP_SERVER_2 "time.google.com"
#define DEFAULT_TZ_POSIX "UTC0"  // until the server sends the real zone
#define DEFAULT_TZ_NAME  "UTC"
// DS3231 clock module (I2C), keeps the time through power cuts on its coin battery.
// VCC to 3V3, GND to GND, SQW and 32K unconnected. Optional: without it, the clock
// waits for NTP as before.
#define RTC_SDA_GPIO 21
#define RTC_SCL_GPIO 47

// ---- Board: ESP32-S3-WROOM-1 N16R8 (16 MB flash, 8 MB PSRAM) only ----
#if !CONFIG_IDF_TARGET_ESP32S3
#error "This firmware is for the ESP32-S3 (N16R8). Build with ./fw.sh, which selects it."
#endif

// MAX98357A amp: GPIO 4/5/6 sit next to each other on the left header.
// Avoid 35-37 (octal PSRAM), 19/20 (USB), 43/44 (serial), 0/3/45/46 (boot pins).
#define I2S_DOUT_GPIO 4
#define I2S_BCLK_GPIO 5
#define I2S_LRC_GPIO  6
#define I2S_PORT I2S_NUM_0
// Status light: RGB LED, common cathode (long leg to GND), each color through 300 Ω.
// GPIO 15/16/17 come right after the amp pins on the same header.
#define LED_R_GPIO 15
#define LED_G_GPIO 16
#define LED_B_GPIO 17
#define LED_STARTING_MS 1500   // white at power-on
#define LED_ONLINE_MS   10000  // green this long after anything else showed, then dark
#define LED_OFFLINE_MS  30000  // can't reach the server this long: red instead of yellow
#define LED_IDENTIFY_MS 4000   // "find my speaker" flashing

// Buttons (buttons.h): each between its pin and GND, the internal pull-up holds it high.
// GPIO 1 and 2 are free, and not boot pins.
#define BTN_STOP_GPIO     1      // STOP · SOS
#define BTN_MOMO_GPIO     2      // MOMO
#define BTN_DEBOUNCE_MS   30
#define BTN_SHORT_MS      1000   // a press, not a hold (MOMO)
#define SOS_HOLD_MS       3000   // STOP held this long: SOS
#define SOS_RETRY_MS      5000   // not answered yet: sent again this often…
#define SOS_RETRY_FOR_MS  600000 // …for up to 10 minutes (offline: it goes when back)
#define SOS_SHOW_MS       30000  // red blinking this long after it went

// ---- Audio ----
#define SAMPLE_RATE 16000     // tones are converted to 16 kHz 16-bit mono WAV by the web page
#define DEFAULT_VOLUME 70     // 0-100, used until the user changes it
#define RING_MAX_MS 60000     // stop ringing after 1 minute if nobody presses Stop
#define MAX_ALARMS 20         // alarms stored on the device (saved in settings storage)
#define SNOOZE_MS (9 * 60 * 1000UL)  // snooze rings again after 9 minutes
#define FADE_IN_MS 30000      // alarms rise from 10% to full volume over 30 s
#define TONE_TIMEOUT_MS 3000  // give up downloading a tone after this and beep instead

// Tones stored on the device (in the 9.9 MB "ffat" area) so alarms play the real tone offline
#define TONE_CACHE_PARTITION "ffat"
#define TONE_RETRY_MS 30000   // after a failed download, try again this much later
// Files open at once on each storage (more gives "Too many open files"). At
// worst on the built-in one: a ringing tone, a tone download, an upload or
// move, a stored-tone check and a wake take. Each is ~4 KB of PSRAM.
#define FFAT_MAX_FILES 6
#define SD_MAX_FILES   4

// microSD card module (SPI, 3V3): GPIO 10-13 sit together on the left header
// and are the S3's own fast SPI pins. Card formatted FAT32.
#define SD_CS_GPIO   10
#define SD_MOSI_GPIO 11
#define SD_SCK_GPIO  12
#define SD_MISO_GPIO 13
#define SD_SPI_HZ    8000000  // 8 MHz: plenty for audio, reliable over jumper wires
#define SD_CHECK_MS  5000     // how often to notice a card being inserted or removed

// INMP441 microphone on the second I2S port (receive). VDD to 3V3 (not 5 V), L/R
// to GND. GPIO 7-9 were free; keep its wires short and away from the amp's.
#define MIC_PORT      I2S_NUM_1
#define MIC_BCLK_GPIO 7   // SCK
#define MIC_WS_GPIO   8   // WS
#define MIC_SD_GPIO   9   // SD: the mic's data out
// The mic gives 24-bit samples; speech at a metre is ~ -60 dB of their full scale.
// Kept as 16-bit with this much gain: 8 is x1, 6 would be x4 (+12 dB). Measured on
// the prototype: at +12 dB a voice half a metre away clipped (peaks at 0 dB); at x1
// it peaks near -12 dB. A quiet recording can be made louder later, a clipped one can't.
#define MIC_GAIN_SHIFT 8
#define MIC_TEST_MAX_S 20     // a test recording is at most this long
#define MIC_LIVE_MAX_S 600    // a call's room audio: at most 10 minutes at a time
// Echo cancellation: the mic hears what the amp played D samples later (rx - tx
// counters). D = the lowest (rx - tx) seen since boot + this calibration, measured
// with the echo test on this hardware (the amp's and the mic's buffering).
#define AEC_DELAY_CAL 1318  // measured 2026-10-16 over two boots (1325, 1311): the amp's 64 ms queue + the mic's buffering
// Interrupting the AI by speaking over it (echo cancellation in conversations).
// Off: the first try stopped it on its own echo and on noise; being tuned.
#define BARGE_IN 0

// Live voice from the browser, the app or the AI (same 16 kHz mono format as tones).
// Over the audio link it arrives as it's made (20-100 ms pieces); over MQTT in 125 ms pieces.
#define TALK_BUF_SAMPLES 16000  // 1 s ring buffer; when full the oldest audio is dropped
#define TALK_PREBUFFER   2000   // wait for 125 ms before playing, to ride out gaps between pieces
#define TALK_DRY_MS      150   // no audio for longer than the I2S queue holds → buffer up again
// Catching up: when a burst leaves more than TALK_CATCHUP_AT waiting while it plays,
// the oldest is dropped down to TALK_CATCHUP_TO, so the delay doesn't stay raised.
// Above what the server keeps ahead on purpose (the AI's voice: 240 ms on the
// audio link, 375 ms over MQTT), so only a real backlog is skipped.
#define TALK_CATCHUP_AT  8000   // 500 ms
#define TALK_CATCHUP_TO  4000   // 250 ms

// ---- Updates over Wi-Fi ----
#define OTA_CONFIRM_MS 180000  // a new version must reach the server within 3 min of boot, or it's rolled back

// ---- Web page stats ----
#define STATS_INTERVAL_MS 2000     // stats while a page is open (the server says "watch")
#define STATS_IDLE_MS     300000   // otherwise a 5-minute heartbeat, to save MQTT traffic
