majharuli0/smart-speaker-esp32/(commit log)

2026-09-15 feat: add initial backend, frontend, ESP32 code, and dependencies
2026-09-24 wip: flash CS on GPIO5, SPI clock fix, format_flash diagnostics
    Snapshot before stripping the project down to a minimal skeleton.
2026-09-29 feat: add core LED demo application with audio worklet, server backend, and ESP32 firmware
2026-09-30 chore: restructure repo into firmware/, backend/, web/, docs/, hardware/
    - esp32/esp32.ino -> firmware/firmware.ino, frontend/ -> web/
    - remove format_flash sketch and old pairing/sound runtime data
    - archive the original audio alarm design doc
2026-09-30 build: pin firmware board settings and versions with arduino-cli profiles
    sketch.yaml profiles for ESP32-S3 N16R8 (16MB, OPI PSRAM, 3MB app/9.9MB FAT,
    USB CDC on boot) and the original ESP32 (Huge APP). fw.sh wraps
    build/upload/monitor. Both profiles compile (S3: 42%, ESP32: 41%).
2026-09-30 feat(firmware): move settings to config.h and report firmware version
    - config.h holds server, pins, audio and timing settings
    - FW_VERSION (0.2.0) sent in hello and stats, shown on the device card
2026-09-30 test(backend): 16 tests for relay, alarms, tones and talk
    Each test file starts a real server on a free port (PORT=0) with mDNS off
    and a temp data folder, then drives it with fake devices and browsers.
    Also fixes PORT=0 being treated as unset (|| -> ??), which made test servers
    collide with the real one on 3000, and reports listen errors clearly.
2026-09-30 ci: run backend tests and compile firmware for both boards on every push
2026-09-30 docs: add protocol reference for every device, server and web message
    README now links to docs/protocol.md instead of keeping its own table.
    Completes Phase 0.
2026-09-30 feat: real time on the device via NTP, with per-device time zones
    Firmware 0.3.0: timesync module starts NTP after Wi-Fi (hourly resync),
    applies a POSIX time zone sent by the server and saves it, reports local
    time and zone in stats. Server stores a zone per device (devices.json,
    default TZ_DEFAULT or the machine's zone), converts it to POSIX, sends it
    on connect and hourly. Page shows the device clock and a 'Use my time
    zone' link. 4 new tests (20 total).
2026-09-30 feat: alarms stored and rung on the device, with an offline beep
    Firmware 0.4.0:
    - alarms module keeps the list in flash, checks it once per minute against
    the device clock (only when the time is valid), rings and reports
    alarm_fired; confirms each sync with alarms_ack
    - built-in 880 Hz beep when the tone can't be downloaded (3 s timeout)
    - network start no longer blocks: with Wi-Fi saved it connects and finds the
    server in the background, so a device restarted while the router is down
    keeps running instead of waiting in the setup hotspot forever
    - NTP first sync retried when Wi-Fi comes up late
    Server: the 1 s scheduler is gone; each device gets its own list
    (alarms_sync, content-h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
    [alarms.cpp, alarms.h, audio.cpp, config.h, firmware.ino, net.cpp, net.h, timesync.cpp]
2026-09-30 feat: store alarm tones on the device so offline alarms play the real tone
    Firmware 0.5.0 (S3): tonecache module mounts the 9.9 MB ffat partition
    (formats it on first boot), downloads the tones the alarms use in the
    background one small piece per loop, checks size + SHA-256 before renaming
    into place, and deletes tones no alarm uses. Alarms play the stored copy
    (offline, gapless loop), then streaming, then the built-in beep. Reports
    {type:cache, stored, wanted}; the flash table now shows storage in use.
    Server: alarm sync lists the tones with size + SHA-256 (cached per file),
    and re-uploading a tone in use re-syncs the devices using it. Page shows
    how many tones are stored. 25 tests.
2026-10-09 feat: firmware updates over Wi-Fi with automatic rollback
    Firmware 0.6.0: ota module downloads into the spare program slot, checks
    SHA-256, installs and restarts. The new version starts on probation and is
    confirmed only once it reaches the server; otherwise (no connection within
    3 min, or a crash) the bootloader goes back to the previous version, which
    reports rolled_back. The binary carries an SSFW:<board>:<version>:END marker;
    hello and stats now include the board.
    Server: POST /firmware checks the image byte, marker and size, keeps the
    newest file per board, and turns a page's ota request into ota_start for
    devices of that board only. Page: Firmware upload section, Update button
    on out-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
    [config.h, firmware.ino, ota.cpp, ota.h, stats.cpp]
2026-10-09 chore: support the ESP32-S3 N16R8 only
    Drop the original ESP32 board: no more #if branches for pins, LED or tone
    storage (now always on), no esp32 build profile or CI job, and no old-board
    notes in the docs. config.h stops the build with a clear error on any other
    chip.
    [audio.cpp, config.h, firmware.ino, stats.cpp, tonecache.cpp, tonecache.h]
2026-10-09 fix: pages opened after a device connects now see its status
    Devices send alarms_ack, cache, volume, partitions once (on connect or on
    change), so a page opened later showed 'waiting for the device to confirm
    its alarms' forever. The server now keeps each device's latest report of
    those kinds (and stats) and replays them to a page when it connects.
2026-10-09 feat: microSD card for tone storage, with built-in storage as fallback
    Firmware 0.7.0: SPI card on GPIO 10-13 (8 MHz). Tones are kept on the card
    and in the built-in 9.9 MB area when they fit, so alarms still have their
    tone if the card is pulled; playing tries the card first. A missing card is
    looked for every 5 s (not while sound plays); a present one is checked by
    reading block 0, and a failed read mid-play checks it at once and carries
    on from built-in storage. Clean-up only touches the device's own files.
    cache reports whether a card is in; partitions carries the card's type,
    size and usage, shown on the page under the flash table.
    [audio.cpp, audio.h, config.h, stats.cpp, tonecache.cpp, tonecache.h]
2026-10-09 chore: show ESP32 core errors and SD card hints for debugging
    Build with DebugLevel=error so drivers explain failures (e.g. why the SD
    card didn't mount), and list what to check when no card is found. 0.7.1.
    [config.h, tonecache.cpp]
2026-10-09 feat: diagnose why the SD card doesn't mount, shown on the page
    When mounting fails, the device sends the card the SD reset command (CMD0)
    directly: no reply means power or contact, a reply means it won't mount
    (format). On 'no reply' it also tries every order of the four signal wires
    on GPIO 10-13, to rule out swapped wires or name the right order. The
    reason goes into partitions.sd.problem and is shown under 'SD card'.
    Core error messages now also go to the USB serial port. 0.7.4.
    [config.h, firmware.ino, tonecache.cpp]
2026-10-10 feat: doorbell from the web page and a visitor page, with a built-in ding-dong
    Firmware 0.8.0: a 'doorbell' command plays a ding-dong generated in code
    (two bell strikes, E5 then C5), skipped while an alarm or talk plays.
    Server: rings from the page (doorbell_ring) or the visitor page
    (POST /bell/<id>, web/bell.html), 10 s cooldown per device, only real
    device IDs. Every ring is logged in events.json and announced to pages,
    which also get the server's LAN address so the visitor link works from a
    phone. Page: Doorbell button and visitor link per device, last 3 rings,
    a banner and optional system notification on a visitor's ring. 36 tests.
    [audio.cpp, audio.h, config.h, firmware.ino]
2026-10-10 feat: snooze, alarm fade-in and one-time alarms
    Firmware 0.9.0: 'snooze' stops a ringing alarm and rings the same tone
    again in 9 min, timed by the device (works offline), replying 'snoozed'
    with the time. Alarms and snooze re-rings fade in from 10% to full volume
    over 30 s. Alarms with a date ring only on that date.
    Server: alarms take an optional date (weekdays then ignored), need a date
    or at least one weekday, and a one-time alarm is switched off when the
    device reports it fired. Page: Snooze button, snoozed status, date field
    in the alarm form. 39 tests.
2026-10-10 feat: watchdog, restart reasons and crash reports
    Firmware 0.10.0: health module reads why the device restarted and, after
    a crash, the coredump summary (task, address, backtrace), sends it once on
    connect and erases it; the loop watchdog restarts the device if loop()
    stops for 5 s (long jobs feed it).
    Server logs each restart as an event next to doorbell rings. Page shows
    the last restart per device, in red with a banner for a crash, freeze or
    brownout, and warns when free RAM gets low. 41 tests.
    [audio.cpp, config.h, firmware.ino, health.cpp, health.h, ota.cpp]
2026-10-10 feat: remove the doorbell cooldown
    Every press of the page button or the visitor page now rings; a press
    during the ding-dong starts it again.
2026-10-10 feat(server): bridge devices over MQTT (EMQX)
    With MQTT_URL set, the server connects to the broker and bridges devices on
    ss/dev/<id>/{cmd,audio,evt,online}. An MQTT device is represented by a link
    that behaves like its WebSocket, so every existing rule (alarms, talk,
    doorbell, updates, replayed reports) works unchanged; message handling moved
    into shared onMessage/onClose. The device ID comes from the topic, never the
    message. Presence uses the retained online flag and the broker's last will;
    the server announces ss/server/online (devices say hello again on '1') and
    ss/server/http (download base URL, PUBLIC_URL to override). WebSocket
    devices still work. Tests run a real in-process broker (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
2026-10-10 feat(firmware): connect to the broker over MQTT/TLS instead of WebSocket
    Firmware 0.11.0: net talks to EMQX with esp-mqtt over TLS (8883), verified
    with the built-in certificate bundle (no CA file). Topics
    ss/dev/<id>/{cmd,audio,evt,online} with a last will; says hello whenever
    ss/server/online turns 1; learns the download base URL from
    ss/server/http, so mDNS and the WebSockets library are gone. Messages from
    the MQTT task are queued and handled on the main loop. The broker login
    lives in firmware/secrets.h (not in git; template secrets.example.h), and
    the build falls back to the template so CI still compiles.
    [audio.cpp, config.h, firmware.ino, net.cpp, net.h, ota.cpp, secrets.example.h]
2026-10-10 feat: send stats often only while a page is open
    The server tells devices 'watch' on/off as the first page opens and the
    last one closes (and on hello). Devices send stats every 2 s while watched
    and every 5 min otherwise, sending one at once when a page opens. Cuts the
    idle MQTT traffic per device from ~20 MB a day to almost nothing.
    Firmware 0.11.1, 48 tests.
2026-10-10 feat(web): cleaner page design, dark mode, and fix the page's server address
    Cards on a light background (dark mode follows the system), a header with
    a connection badge, and each device card grouped into Sound / Doorbell /
    Device, volume, Alarms (day chips, tidier add form) and a folded 'Health &
    storage' section that stays open across redraws. Banners show only when
    there's something to say; destructive buttons are red.
    Fix: a page served from any port other than 3000 connected to
    localhost:3000 instead of its own server. It now uses its own address, and
    falls back to localhost:3000 only when opened as a file or from Live
    Server.
2026-10-10 feat: printable doorbell QR code per device
    GET /bell/<id>/qr serves a printable page with a QR code (generated on the
    server with the qrcode package) for the visitor link, using PUBLIC_URL or
    the LAN address, and warns when the link only works on the home Wi-Fi.
    Each device card links to it. 49 tests.
2026-10-10 docs: M2 backend code done, real-device check pending
2026-10-10 fix(firmware): 1 s talk buffer for 125 ms audio pieces (0.11.2)
    EMQX Serverless allows a client 10 published messages a second, so the
    server now sends talk audio in 125 ms pieces instead of 20 ms chunks;
    the device needs a bigger buffer to play them smoothly.
    [config.h]
2026-10-10 feat(firmware): Wi-Fi setup over Bluetooth with the QR label code (0.12.0)
    Replaces the WiFiManager hotspot with Espressif's BLE provisioning
    (security 1). The code is HMAC-SHA256(DEVICE_SECRET, device ID), the
    same one the backend checks when the device is claimed. Bluetooth is
    freed after setup; reset_wifi erases the Wi-Fi and restarts into setup.
    [config.h, firmware.ino, net.cpp, net.h, secrets.example.h]
2026-10-10 feat(firmware): each speaker logs in to our own broker as itself (0.13.0)
    Username = device ID, password = HMAC-SHA256(DEVICE_SECRET, "mqtt:" + ID);
    the backend checks it and the topics each speaker may use. The broker
    address is MQTT_URI in secrets.h; the shared EMQX Cloud login is gone.
    [config.h, net.cpp, secrets.example.h]
2026-10-10 docs: plan M7, building units at home with a secret per unit and printed labels
2026-10-10 feat(firmware): find the broker by name on the local network (0.13.1)
    MQTT_URI mqtt://speaker-server.local:1883 is looked up over mDNS (the
    backend answers it), before connecting and again after 30 s without the
    broker, so the computer's address can change.
    [config.h, net.cpp, secrets.example.h]
2026-10-15 feat(firmware): INMP441 microphone and a test recording (0.19.0)
    - mic.cpp: INMP441 on I2S port 1 (GPIO 7 SCK, 8 WS, 9 SD; L/R to GND), on its
    own task. Reads both slots and keeps the louder (the mic's L/R pin decides),
    removes the DC offset, gain x1 (MIC_GAIN_SHIFT 8: +12 dB clipped a voice at
    half a metre), skips the 300 ms start-up thump.
    - mic_test {seconds} streams the recording on ss/dev/<id>/mic in 125 ms pieces
    with mic_level every 250 ms, then mic_done; mic_stop / stop end it early.
    - Live data is published directly (netSendMic, netSendNow): the MQTT queue
    sends about one queued message per pass of its task, and 3 s of audio took
    23 s to arrive.
    - The status light pulses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
2026-10-15 fix(firmware): a "ready" cue, and speech detection that works (0.21.0)
    Voice requests often ended as "nothing heard": the background was measured in
    the first 300 ms, so someone already talking became the background. Now:
    - a short rising cue plays before the mic opens for a voice request;
    - the background is the quietest recent 50 ms window (drops at once, rises
    ~2 dB a second); speech is 12 dB above it for 100 ms, quiet is under 8 dB
    above it. Checked on the prototype's recordings: the background wanders
    0-8 dB above its floor, speech is 15-34 dB above; speech was found in every
    recording with speech (the old rule found 1 of 7) and in none of the quiet ones.
    - mic_done reports the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
2026-10-15 Firmware 0.23.0: react to the wake word at once
    The mic keeps the last 6 s in PSRAM. On the wake word the speaker beeps at once
    and marks where the word ended; the server's mic_record with afterWake gets the
    audio from there, so "হাই মোমো … কাশেমকে ফোন দাও" said in one go works.
2026-10-15 Firmware 0.24.0: hear speech over a ceiling fan
    Speech is now judged in 100-1000 Hz (wake::SpeechBand, shared by recordings
    and the wake word listener): measured with a fan on, the fan alone stayed under
    3 dB above its floor there (8.6 dB across all frequencies), and a voice a few
    metres away reached 15.4 dB (11.8 dB). Speech is +10 dB in the band, quiet
    under +5 dB. Wake word features start at 150 Hz, above the fan's rumble; takes
    from older firmware are left unused (record them again).
    On the PC: the owner's real takes are found as single words, fan-only and
    fan-off silences give no words, and the generated set went from 16/24 detected
    with 137 false matches to 18/24 with 49.
    Co-Authored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
2026-10-15 README: the amp's GAIN pin is wired to GND (12 dB)
2026-10-15 Firmware 0.27.0: the audio link
    Live audio goes over the speaker's own WebSocket (esp_transport_ws, TLS for
    wss://) instead of the MQTT broker: mic frames from a PSRAM outbox, talk audio
    and talk_start/stop in, handed to the main loop like MQTT messages. It logs in
    with its MQTT credentials and falls back to MQTT while it's down. Data sent over
    it must be writable (the client masks frames in place); frames too big for the
    buffer are skipped whole, so the stream stays in step.
2026-10-15 Firmware 0.28.0: Opus on the audio link
    The link task encodes the mic (esp32_opus 1.0.3: libopus, fixed point; 16 kHz
    mono, 24 kb/s, complexity 2) and decodes talk audio, on its own 32 KB stack
    (measured: ~9.5 KB left at the deepest). Mic pieces are 120 ms (6 frames of
    20 ms). Measured on the speaker: about a tenth of the data raw PCM needed.
    Without the library starting, it falls back to raw PCM.
2026-10-15 Firmware 0.29.0: echo cancellation spike (measured)
    - One output task feeds the amp continuously (silence when idle) and keeps
    every played sample, numbered, as the echo reference
    - Echo test: a 2 s sweep while recording; optionally through ESP-SR's echo
    canceller (FD low-cost mode, in PSRAM, created at boot)
    - Echo delay from the steady (rx - tx) over the last second + a measured
    calibration; stable across reboots
    - Audio link task stack in PSRAM, to leave internal RAM for Wi-Fi
    Measured: 15-30 dB of echo removed, the talker's voice kept, 10 ms CPU
    per 32 ms chunk.
2026-10-15 Firmware 0.30.0: interrupting by voice, tried and switched off (BARGE_IN 0)
    Echo cancellation in conversations with a double-talk check, kept behind
    BARGE_IN (off): on this open prototype the AI's own echo and room noise
    stopped it. Conversations work as in 0.29. The background level is no
    longer raised by the speaker's own sound.
2026-10-16 Firmware 0.30.2: no freeze after uploads, more open files, link retry log
    - Serial: with USB on a PC but no monitor reading, each print could wait up
    to 2 s (core messages 100 ms per character), tripping the 5 s loop
    watchdog about 12 s after nearly every upload ("froze"). Now 1 ms per try
    (Serial.setTxTimeoutMs(1)), which still keeps up with a reading monitor.
    - Storage: FFat and the SD card allowed only 2 open files, so a ringing tone
    plus a tone download made any third open fail ("Too many open files").
    Now FFAT_MAX_FILES 6 and SD_MAX_FILES 4; the slots are in PSRAM.
    - Audio link: failed reconnect attempts are logged (the first, then about
    once a minute); before, they were sil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
2026-10-16 Docs: scope cut for now (help button, smart home, news, multi-room, offline commands)
2026-10-16 Docs: voice stop/snooze for alarms skipped; physical buttons planned later
2026-10-17 Firmware 0.31.1: DS3231 battery clock (GPIO 21/47) sets the time at boot, alarms ring offline
2026-10-18 Firmware 0.32.0: audio path counters in stats (audio plan, phase 0)
    Talk buffer drops, dry spells and peak, underruns while talk plays, inbox and
    mic outbox drops, audio link drops, slowest link send, and gaps in the talk
    frame numbers. Totals since boot, in the stats message under "audio".
2026-10-18 firmware: secrets example lists the real cloud and local broker addresses
    The device secret stays a placeholder: this repo is public.
2026-10-18 Firmware 0.36.0: noise filter for calls (audio plan, phase 3)
    mic_record ns 1-3: a 180 Hz 4th-order high-pass, then ESP-SR noise suppression
    on its own task on core 0 (17% of a core; core 1 runs the echo canceller), with
    -18 dB of the raw sound mixed back. Buffers in PSRAM. Speech and turns are
    judged on the raw sound, the filtered sound is sent ~20 ms later. mic_done
    reports ns and nsDrops. Docs: phase 3 results so far, the quiet-room ticks.
2026-10-19 Firmware 0.36.1: two mics on one port; the quieter is used, a mic test can pick one or both
    Two INMP441s can share the mic port (L/R pin to GND and to 3V3). At power-on
    each slot's quietest 50 ms over 2 s decides: no mic and a floating line are
    skipped, and of the mics the quieter one is used (one picking up interference
    is the louder; the old rule took the louder). Calls and conversations use that
    mic. A mic test can ask for left, right or both averaged (mic 1-3), and
    mic_done reports each slot's quietest level (slots).
2026-10-19 Firmware 0.37.0: STOP · SOS and MOMO buttons (GPIO 1 and 2)
    STOP: a press stops everything at once (alarm, music, talk, Momo, a call);
    held 3 s it sends an SOS, chimes and blinks red, and resends every 5 s until
    the server answers (up to 10 minutes). MOMO: a short press asks the server to
    start a conversation. Wiring in the README, messages in protocol.md.
2026-10-20 docs: wiring diagram of the whole speaker on the DevKit's real pin order
2026-10-20 docs: wiring diagram without the capacitor row and power-on checklist
2026-10-20 docs: wiring diagram without the pins-to-leave-free list
2026-10-20 docs: wiring diagram in light theme only
2026-10-20 docs: parts list with where each part was bought; 4 ohm 5 W speaker, 330 ohm resistors
2026-10-20 docs: report-style circuit diagram with photos of each part (PNG and page)
2026-10-20 docs: circuit diagram with a front photo of the ESP32-S3 board
2026-10-20 docs: circuit diagram marks the unused pins (clock SQW, 32K; amp SD) as not connected
2026-10-20 docs: circuit diagram with a speaker photo, wired from the amp's screw terminal
